apuder/MiniPC/src/esp/doc/programmer-20k.jpg

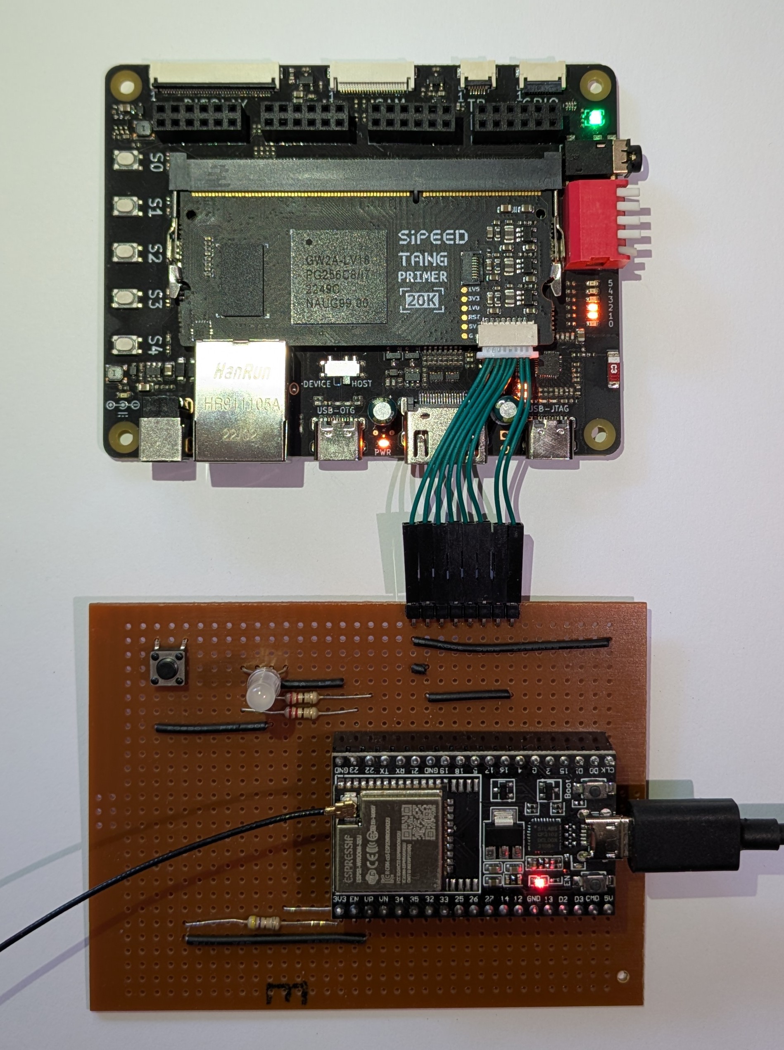
src/esp/doc/programmer-20k.jpg
