apuder/MiniPC/src/esp/doc/web-ui.png

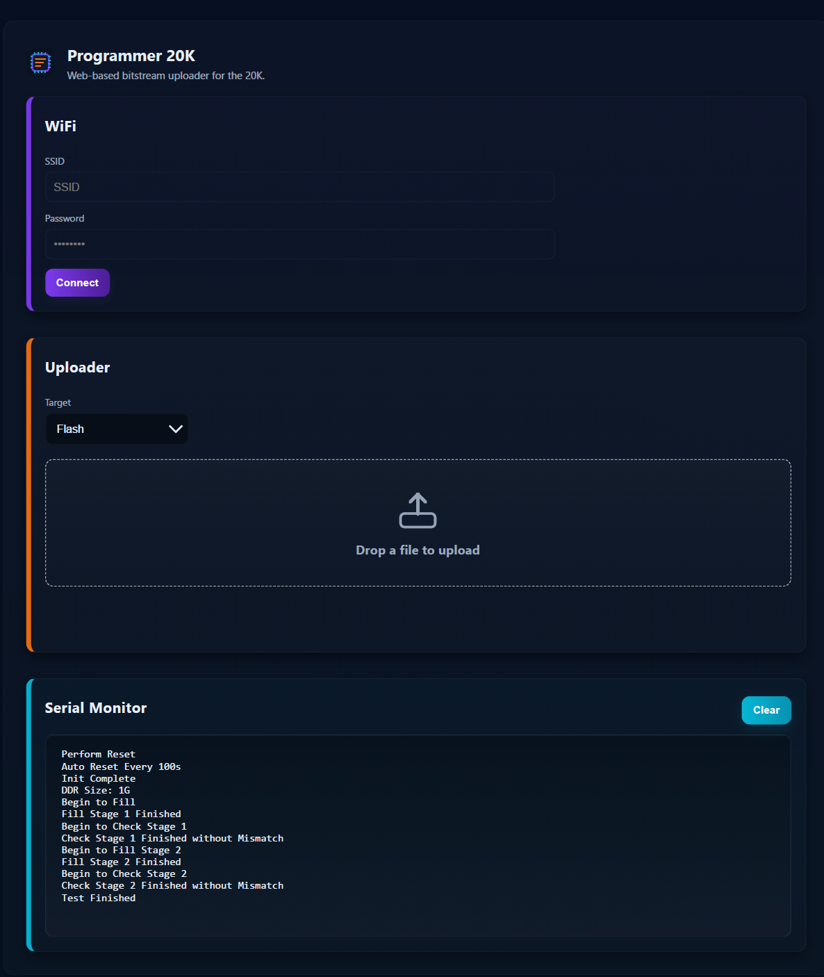
src/esp/doc/web-ui.png
