apuder/MiniPC/src/esp/doc/Programmer-20K-ESP.pdf

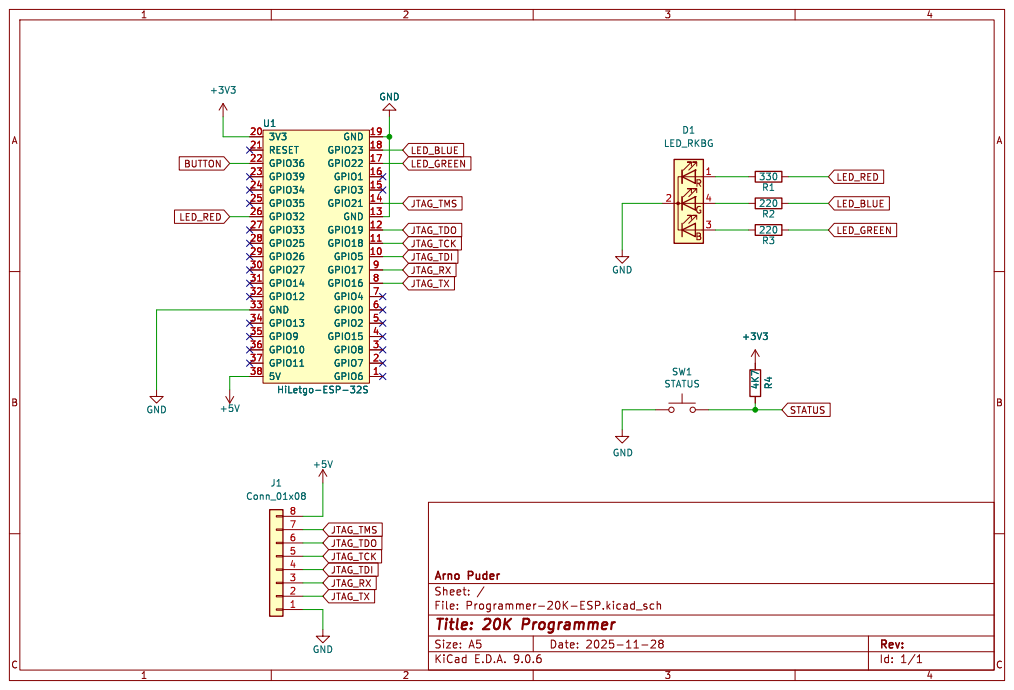
[picture p3: page 1]
