apuder/MiniPC/kicad/pc/v0.2/MiniPC.kicad_pcb

## KiCad design kicad/pc/v0.2/MiniPC.kicad_pcb (2026-04-09)

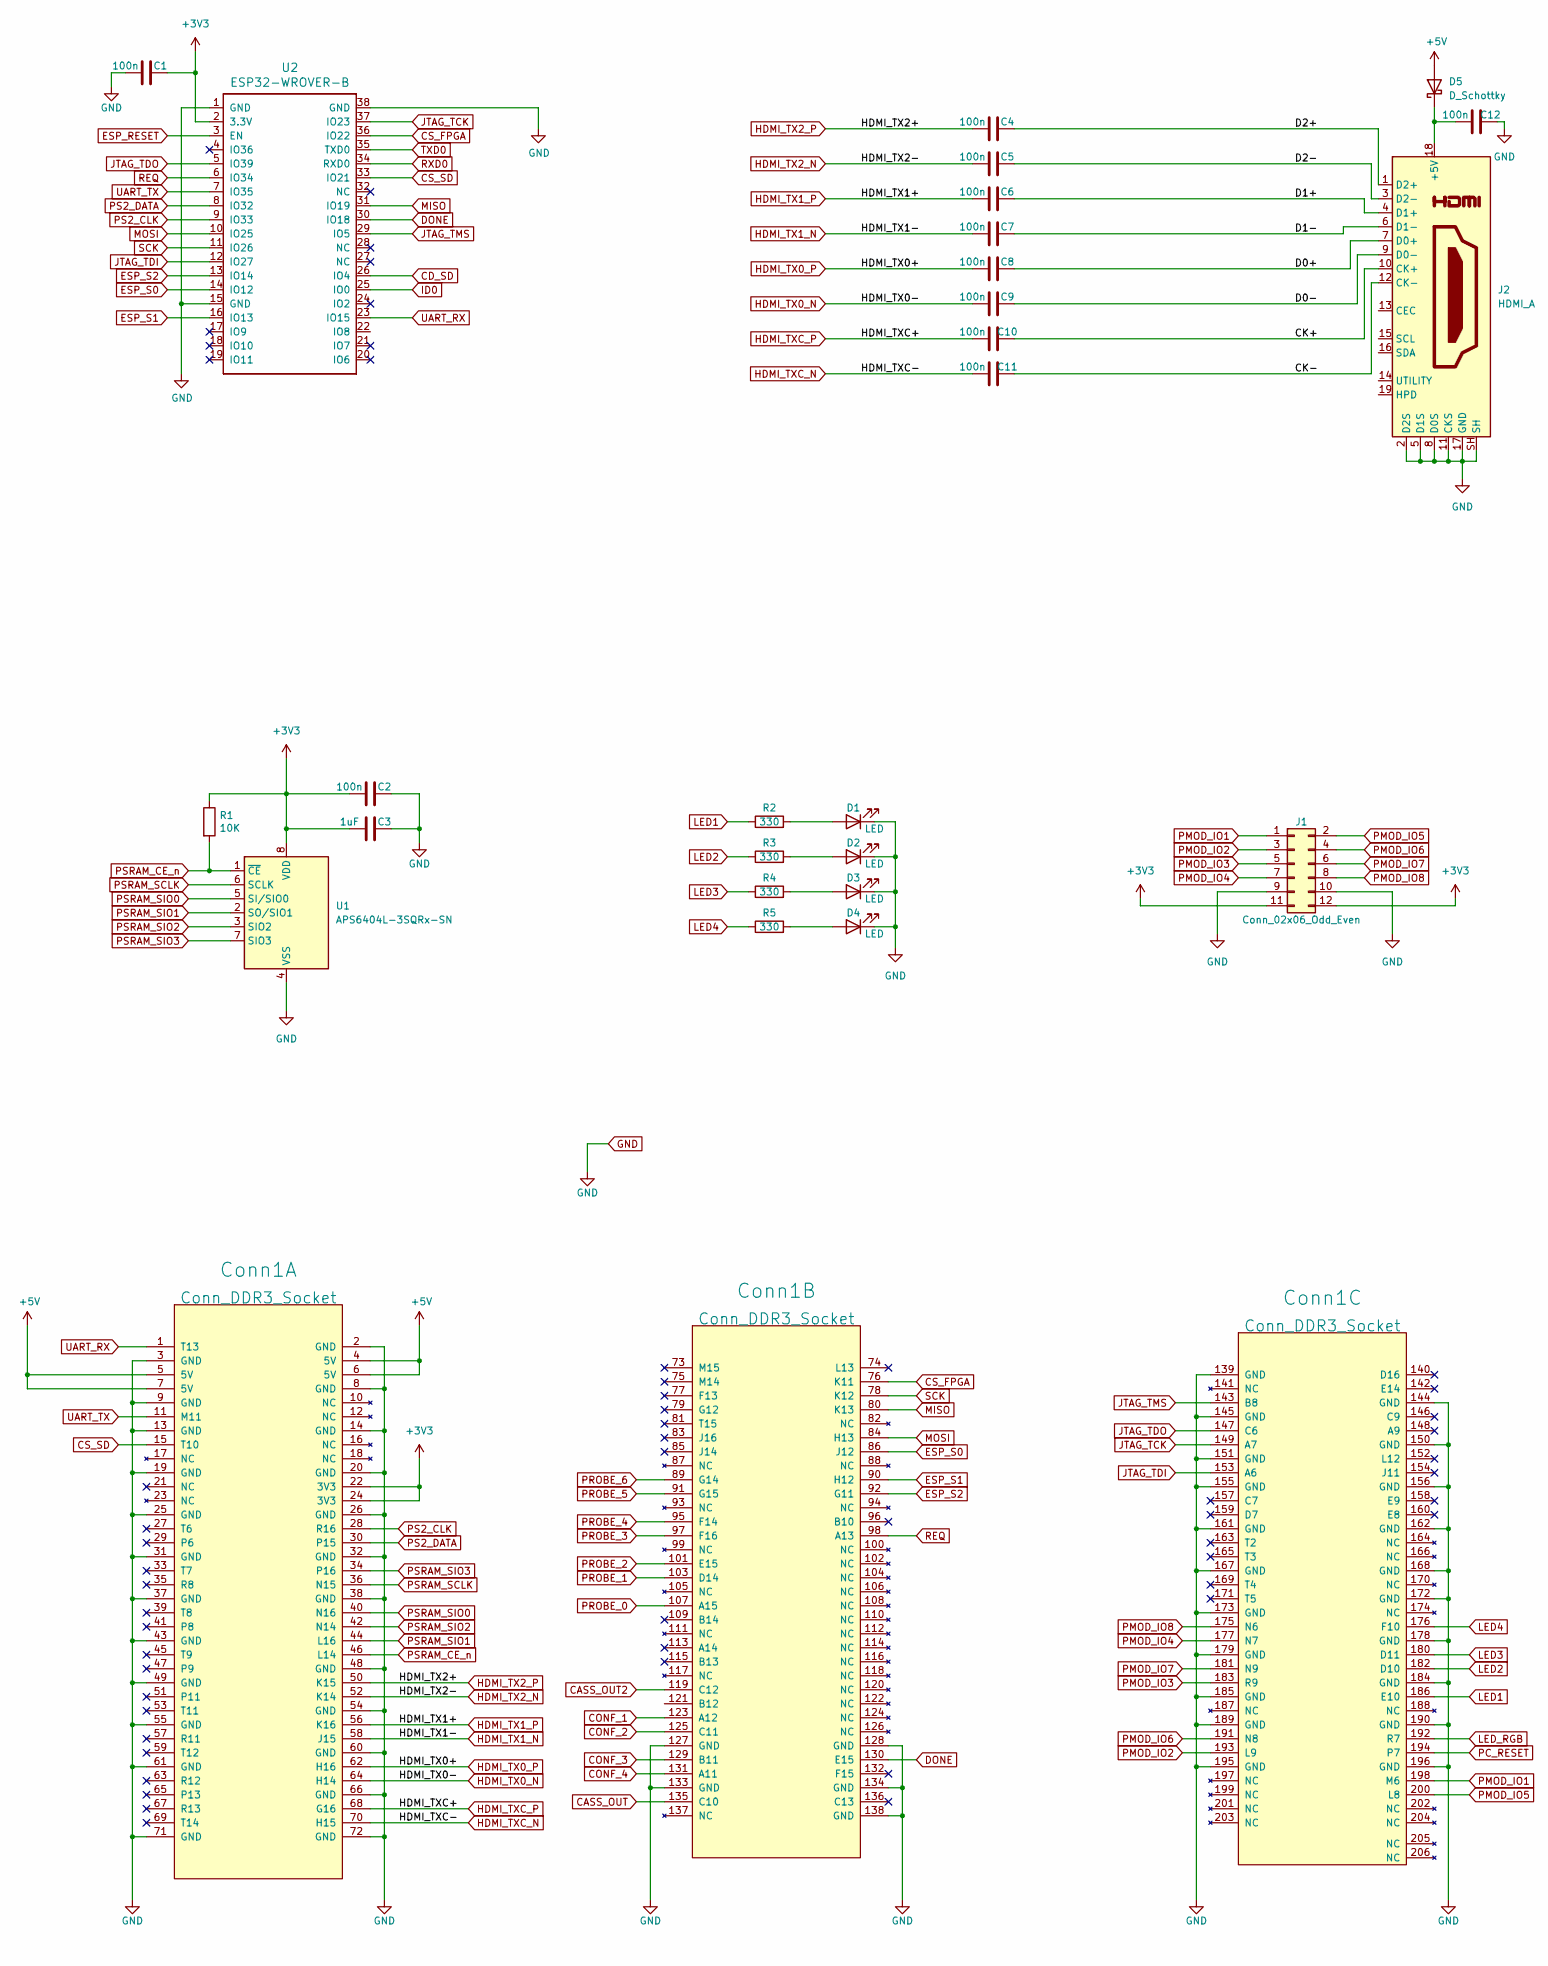
[picture p4: schematic MiniPC.kicad_sch, part in row 1, column 1]

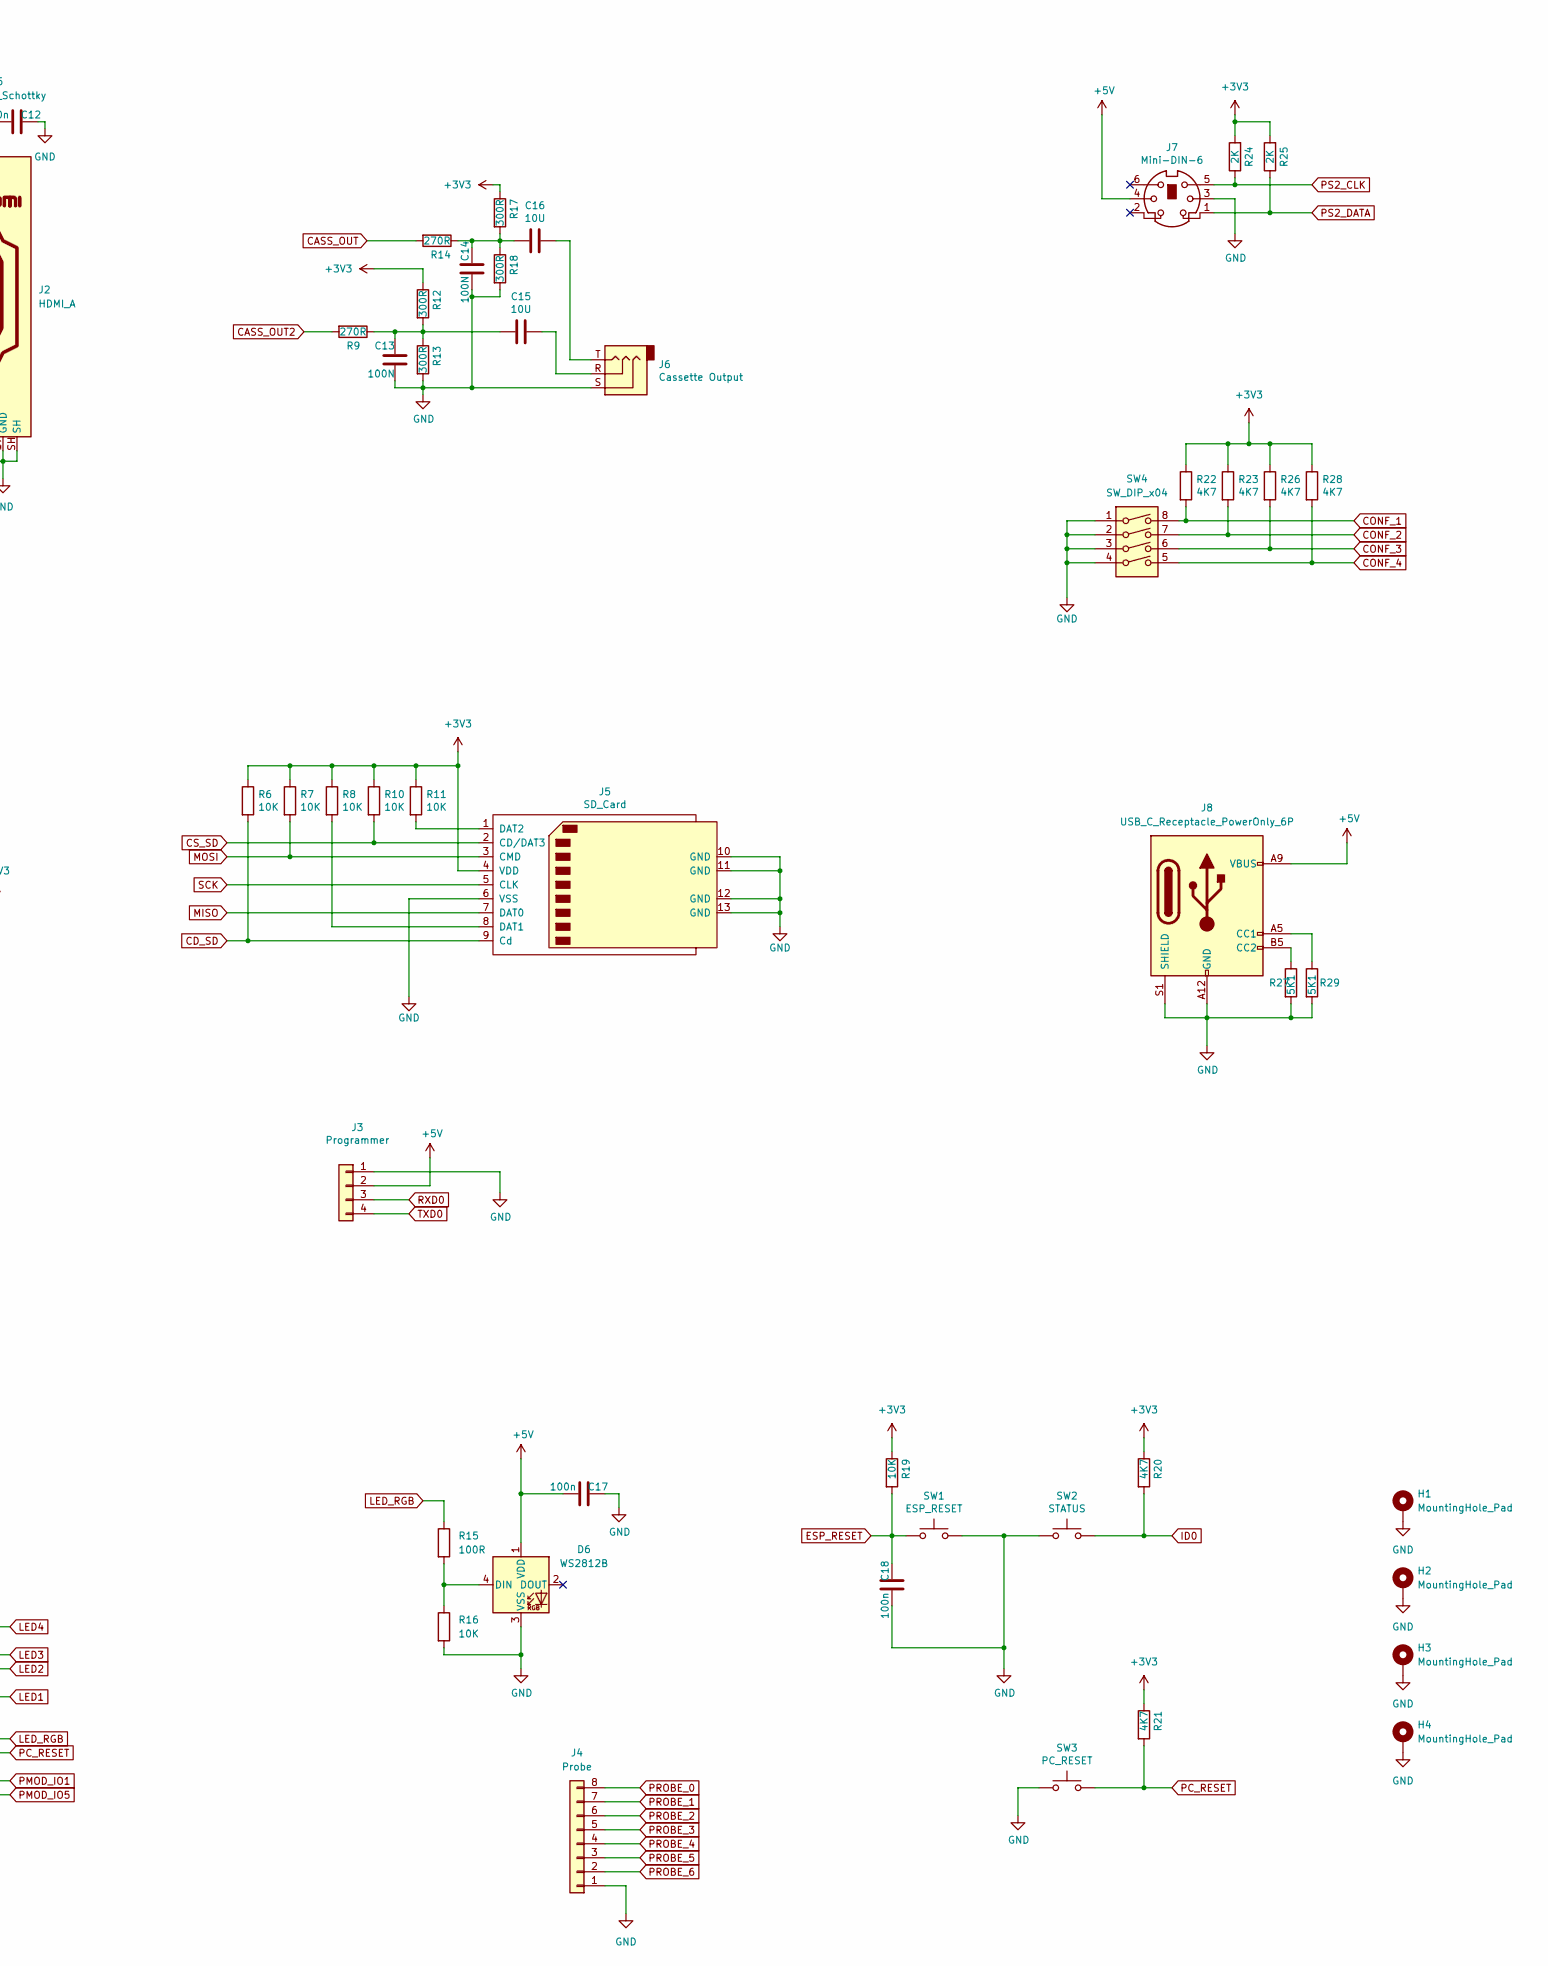
[picture p5: schematic MiniPC.kicad_sch, part in row 1, column 2]

Parts:
C1, C2, C4, C5, C6, C7, C8, C9, C10, C11, C12, C17, C18: 100n; C_0805_2012Metric_Pad1.18x1.45mm_HandSolder
C3: 1uF; C_0805_2012Metric_Pad1.18x1.45mm_HandSolder
C13, C14: 100N; C_0805_2012Metric_Pad1.18x1.45mm_HandSolder
C15, C16: 10U; C_1206_3216Metric_Pad1.33x1.80mm_HandSolder
Conn1: Conn_DDR3_Socket; DDR3_socket; LCSC C306045
D1: LED; LED_0805_2012Metric_Pad1.15x1.40mm_HandSolder; LCSC C84256
D2, D3, D4: LED; LED_0805_2012Metric_Pad1.15x1.40mm_HandSolder
D5: D_Schottky; D_SOD-323; LCSC C1884554
D6: WS2812B; LED_WS2812B_PLCC4_5.0x5.0mm_P3.2mm; LCSC C2761795
H1, H2, H3, H4: MountingHole_Pad; MountingHole_3mm_Pad_Via
J1: Conn_02x06_Odd_Even; PinSocket_2x06_P2.54mm_Vertical; LCSC C358728
J2: HDMI_A; HDMI_A_Molex_208658-1001_Horizontal; LCSC C5184845
J3: Programmer; PinHeader_1x04_P2.54mm_Vertical; LCSC C2691448
J4: Probe; PinHeader_1x08_P2.54mm_Vertical
J5: SD_Card; TFP09-2-12B; LCSC C91145
J6: Cassette Output; Jack_3.5mm_CUI_SJ1-3535NG_Horizontal_CircularHoles; LCSC C2884945
J7: Mini-DIN-6; minidin_6_ps2_pcb_mount; LCSC C77848
J8: USB_C_Receptacle_PowerOnly_6P; USB_C_Receptacle_GCT_USB4125-xx-x_6P_TopMnt_Horizontal; LCSC C168701
R1, R6, R7, R8, R10, R11, R16, R19: 10K; R_0805_2012Metric_Pad1.20x1.40mm_HandSolder
R2, R3, R4, R5: 330; R_0805_2012Metric_Pad1.20x1.40mm_HandSolder
R9, R14: 270R; R_0805_2012Metric_Pad1.20x1.40mm_HandSolder
R12, R13, R17, R18: 300R; R_0805_2012Metric_Pad1.20x1.40mm_HandSolder
R15: 100R; R_0805_2012Metric_Pad1.20x1.40mm_HandSolder
R20, R21, R22, R23, R26, R28: 4K7; R_0805_2012Metric_Pad1.20x1.40mm_HandSolder
R24, R25: 2K; R_0805_2012Metric_Pad1.20x1.40mm_HandSolder
R27, R29: 5K1; R_0805_2012Metric_Pad1.20x1.40mm_HandSolder
SW1: ESP_RESET; SW_Push_1P1T_NO_E-Switch_TL3301NxxxxxG; LCSC C255812
SW2: STATUS; SW_Push_1P1T_NO_E-Switch_TL3301NxxxxxG; LCSC C255812
SW3: PC_RESET; SW_Push_1P1T_NO_E-Switch_TL3301NxxxxxG; LCSC C255812
SW4: SW_DIP_x04; SW_DIP_SPSTx04_Slide_6.7x11.72mm_W8.61mm_P2.54mm_LowProfile; LCSC C2842911
U1: APS6404L-3SQRx-SN; SOIC-8_3.9x4.9mm_P1.27mm; LCSC C5333729
U2: ESP32-WROVER-B; ESP32-WROVER; LCSC C529589

Connections:
+3V3: C1.2, C2.1, C3.1, Conn1.22 (3V3), Conn1.24 (3V3), J1.11, J1.12, J5.4 (VDD), R1.1, R6.1, R7.1, R8.1, R10.1, R11.1, R12.1, R17.1, R19.1, R20.1, R21.1, R22.1, R23.1, R24.2, R25.2, R26.1, R28.1, U1.8 (VDD), U2.2 (3.3V)
+5V: C17.1, Conn1.4 (5V), Conn1.5 (5V), Conn1.6 (5V), Conn1.7 (5V), D5.2 (A), D6.1 (VDD), J3.2, J7.4, J8.A9 (VBUS), J8.B9 (VBUS)
/CK+: C10.2, J2.10 (CK+)
/CK-: C11.2, J2.12 (CK-)
/D0+: C8.2, J2.7 (D0+)
/D0-: C9.2, J2.9 (D0-)
/D1+: C6.2, J2.4 (D1+)
/D1-: C7.2, J2.6 (D1-)
/D2+: C4.2, J2.1 (D2+)
/D2-: C5.2, J2.3 (D2-)
CASS_OUT: Conn1.135 (C10), R14.2
CASS_OUT2: Conn1.119 (C12), R9.2
CD_SD: J5.9 (Cd), R6.2, U2.26 (IO4)
CONF_1: Conn1.123 (A12), R22.2, SW4.8
CONF_2: Conn1.125 (C11), R23.2, SW4.7
CONF_3: Conn1.129 (B11), R26.2, SW4.6
CONF_4: Conn1.131 (A11), R28.2, SW4.5
CS_FPGA: Conn1.76 (K11), U2.36 (IO22)
CS_SD: Conn1.15 (T10), J5.2 (CD/DAT3), R10.2, U2.33 (IO21)
DONE: Conn1.130 (E15), U2.30 (IO18)
ESP_RESET: C18.2, R19.2, SW1.1, U2.3 (EN)
ESP_S0: Conn1.86 (J12), U2.14 (IO12)
ESP_S1: Conn1.90 (H12), U2.16 (IO13)
ESP_S2: Conn1.92 (G11), U2.13 (IO14)
GND: C1.1, C2.2, C3.2, C12.2, C13.2, C14.2, C17.2, C18.1, Conn1.2 (GND), Conn1.3 (GND), Conn1.8 (GND), Conn1.9 (GND), Conn1.13 (GND), Conn1.14 (GND), Conn1.19 (GND), Conn1.20 (GND), Conn1.25 (GND), Conn1.26 (GND), Conn1.31 (GND), Conn1.32 (GND), Conn1.37 (GND), Conn1.38 (GND), Conn1.43 (GND), Conn1.48 (GND), Conn1.49 (GND), Conn1.54 (GND), Conn1.55 (GND), Conn1.60 (GND), Conn1.61 (GND), Conn1.66 (GND), Conn1.71 (GND), Conn1.72 (GND), Conn1.127 (GND), Conn1.128 (GND), Conn1.133 (GND), Conn1.134 (GND), Conn1.138 (GND), Conn1.139 (GND), Conn1.144 (GND), Conn1.145 (GND), Conn1.150 (GND), Conn1.151 (GND), Conn1.155 (GND), Conn1.156 (GND), Conn1.161 (GND), Conn1.162 (GND), Conn1.167 (GND), Conn1.168 (GND), Conn1.172 (GND), Conn1.173 (GND), Conn1.178 (GND), Conn1.179 (GND), Conn1.184 (GND), Conn1.185 (GND), Conn1.189 (GND), Conn1.190 (GND), Conn1.195 (GND), Conn1.196 (GND), D1.1 (K), D2.1 (K), D3.1 (K), D4.1 (K), D6.3 (VSS), H1.1, H2.1, H3.1, H4.1, J1.9, J1.10, J2.2 (D2S), J2.5 (D1S), J2.8 (D0S), J2.11 (CKS), J2.17 (GND), J2.SH, J3.1, J4.1, J5.6 (VSS), J5.10 (GND), J5.11 (GND), J5.12 (GND), J5.13 (GND), J6.S, J7.3, J8.A12 (GND), J8.B12 (GND), J8.S1 (SHIELD), R13.2, R16.2, R18.2, R27.2, R29.2, SW1.2, SW2.1, SW3.1, SW4.1, SW4.2, SW4.3, SW4.4, U1.4 (VSS), U2.1 (GND), U2.15 (GND), U2.38 (GND)
HDMI_TX0_N: C9.1, Conn1.64 (H14)
HDMI_TX0_P: C8.1, Conn1.62 (H16)
HDMI_TX1_N: C7.1, Conn1.58 (J15)
HDMI_TX1_P: C6.1, Conn1.56 (K16)
HDMI_TX2_N: C5.1, Conn1.52 (K14)
HDMI_TX2_P: C4.1, Conn1.50 (K15)
HDMI_TXC_N: C11.1, Conn1.70 (H15)
HDMI_TXC_P: C10.1, Conn1.68 (G16)
ID0: R20.2, SW2.2, U2.25 (IO0)
JTAG_TCK: Conn1.149 (A7), U2.37 (IO23)
JTAG_TDI: Conn1.153 (A6), U2.12 (IO27)
JTAG_TDO: Conn1.147 (C6), U2.5 (IO39)
JTAG_TMS: Conn1.143 (B8), U2.29 (IO5)
LED1: Conn1.186 (E10), R2.1
LED2: Conn1.182 (D10), R3.1
LED3: Conn1.180 (D11), R4.1
LED4: Conn1.176 (F10), R5.1
LED_RGB: Conn1.192 (R7), R15.1
MISO: Conn1.80 (K13), J5.7 (DAT0), U2.31 (IO19)
MOSI: Conn1.84 (H13), J5.3 (CMD), R7.2, U2.10 (IO25)
unnamed: C13.1, C15.2, R9.1, R12.2, R13.1
unnamed: C14.1, C16.2, R14.1, R17.2, R18.1
unnamed: C15.1, J6.R
unnamed: C16.1, J6.T
unnamed: D1.2 (A), R2.2
unnamed: D2.2 (A), R3.2
unnamed: D3.2 (A), R4.2
unnamed: D4.2 (A), R5.2
unnamed: C12.1, D5.1 (K), J2.18 (+5V)
unnamed: D6.4 (DIN), R15.2, R16.1
unnamed: J5.8 (DAT1), R8.2
unnamed: J5.1 (DAT2), R11.2
unnamed: J8.A5 (CC1), R29.1
unnamed: J8.B5 (CC2), R27.1
PC_RESET: Conn1.194 (P7), R21.2, SW3.2
PMOD_IO1: Conn1.198 (M6), J1.1
PMOD_IO2: Conn1.193 (L9), J1.3
PMOD_IO3: Conn1.183 (R9), J1.5
PMOD_IO4: Conn1.177 (N7), J1.7
PMOD_IO5: Conn1.200 (L8), J1.2
PMOD_IO6: Conn1.191 (N8), J1.4
PMOD_IO7: Conn1.181 (N9), J1.6
PMOD_IO8: Conn1.175 (N6), J1.8
PROBE_0: Conn1.107 (A15), J4.8
PROBE_1: Conn1.103 (D14), J4.7
PROBE_2: Conn1.101 (E15), J4.6
PROBE_3: Conn1.97 (F16), J4.5
PROBE_4: Conn1.95 (F14), J4.4
PROBE_5: Conn1.91 (G15), J4.3
PROBE_6: Conn1.89 (G14), J4.2
PS2_CLK: Conn1.28 (R16), J7.5, R24.1, U2.9 (IO33)
PS2_DATA: Conn1.30 (P15), J7.1, R25.1, U2.8 (IO32)
PSRAM_CE_n: Conn1.46 (L14), R1.2, U1.1 (~CE)
PSRAM_SCLK: Conn1.36 (N15), U1.6 (SCLK)
PSRAM_SIO0: Conn1.40 (N16), U1.5 (SI/SIO0)
PSRAM_SIO1: Conn1.44 (L16), U1.2 (SO/SIO1)
PSRAM_SIO2: Conn1.42 (N14), U1.3 (SIO2)
PSRAM_SIO3: Conn1.34 (P16), U1.7 (SIO3)
REQ: Conn1.98 (A13), U2.6 (IO34)
RXD0: J3.3, U2.34 (RXD0)
SCK: Conn1.78 (K12), J5.5 (CLK), U2.11 (IO26)
TXD0: J3.4, U2.35 (TXD0)
UART_RX: Conn1.1 (T13), U2.23 (IO15)
UART_TX: Conn1.11 (M11), U2.7 (IO35)

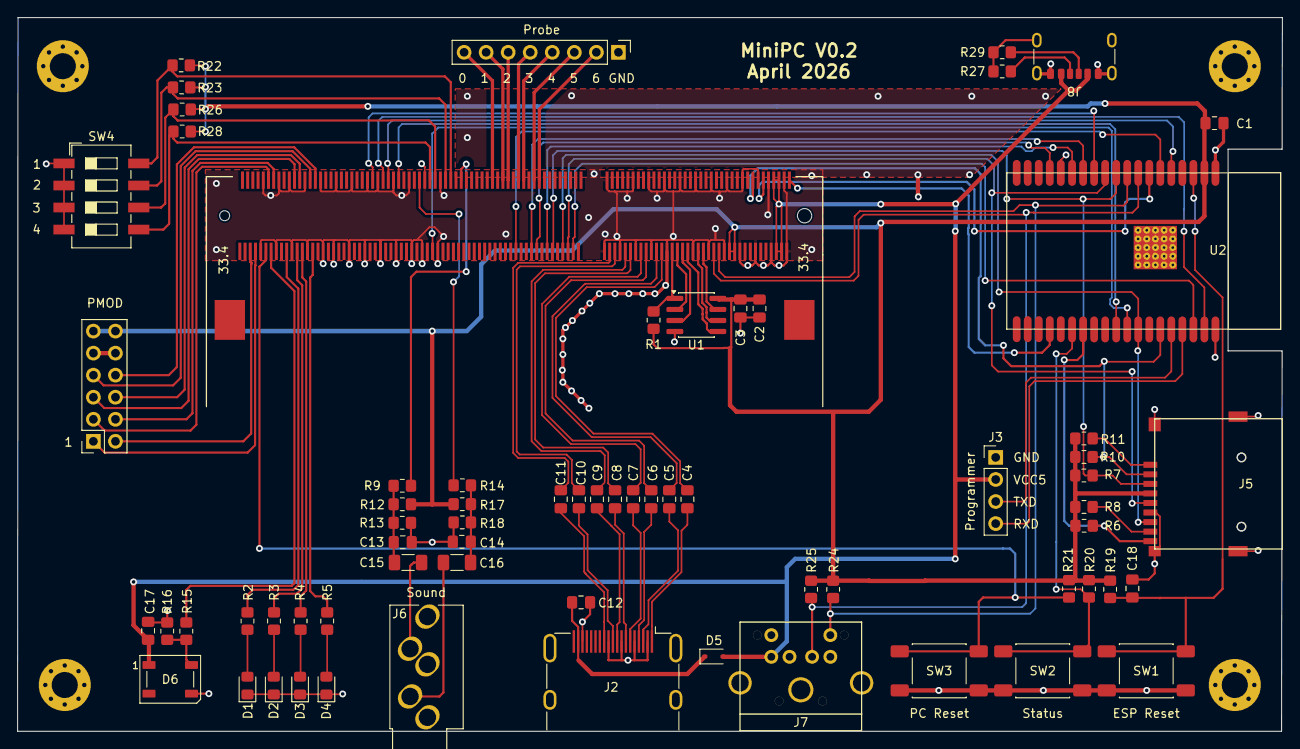
[picture p6: board MiniPC.kicad_pcb from above]

Board: 2 copper layers, 145.7 x 82.2 mm, 72 parts (0 on the bottom side), 89 nets.
