apuder/MiniPC/kicad/pmod/rs232/rs232.kicad_pcb

## KiCad design kicad/pmod/rs232/rs232.kicad_pcb (2026-03-08)

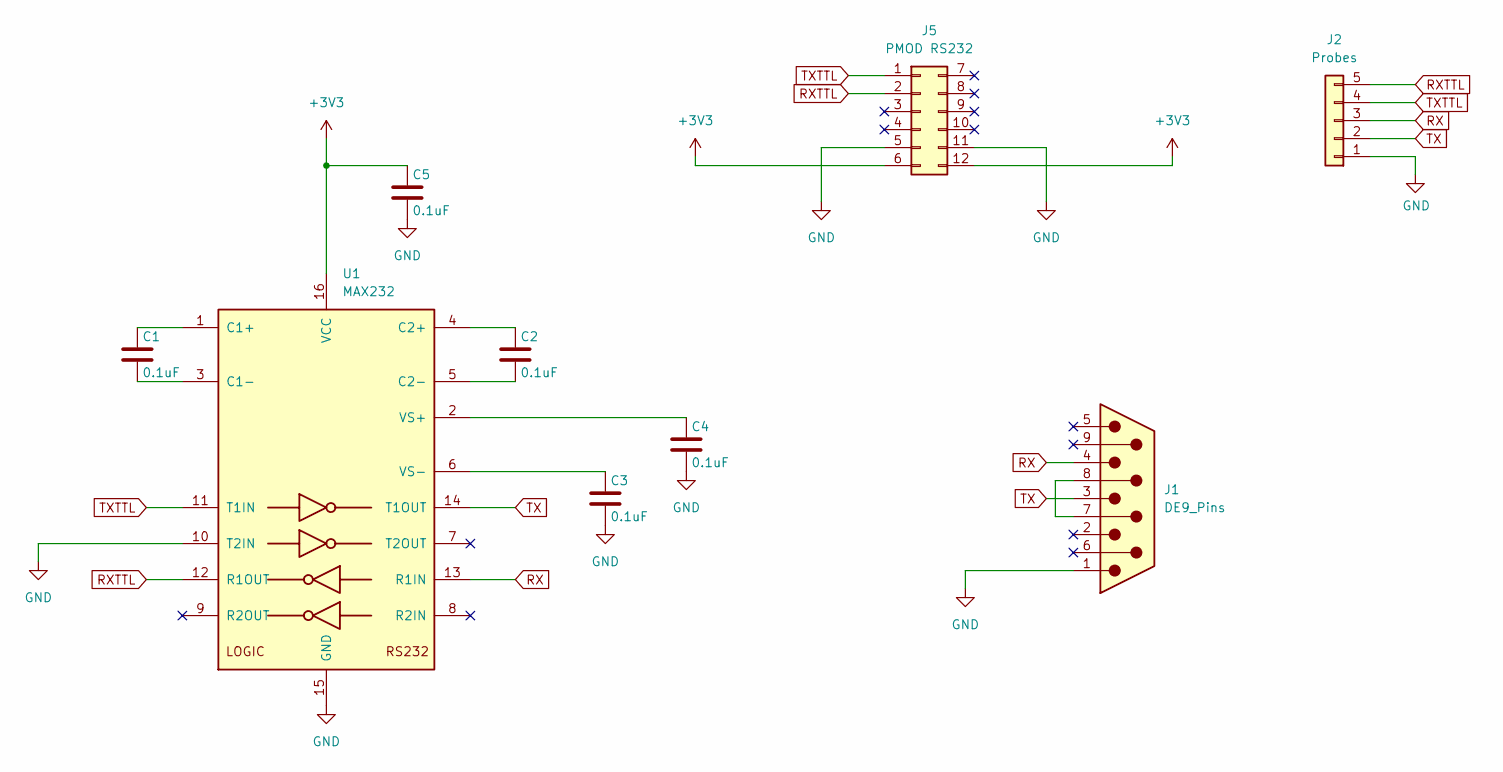
[picture p7: schematic rs232.kicad_sch, PMOD - RS232]

Parts:
C1, C2, C3, C4, C5: 0.1uF; C_0805_2012Metric_Pad1.18x1.45mm_HandSolder; LCSC C49678
J1: DE9_Pins; DSUB-9_Socket_Horizontal_P2.77x2.84mm_EdgePinOffset7.70mm_H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
J2: Probes; PinHeader_1x05_P2.54mm_Vertical
J5: PMOD RS232; PinSocket_2x06_Top_Bottom_P2.54mm_Vertical; LCSC C358728
U1: MAX232; TSSOP-16_4.4x5mm_P0.65mm; LCSC C406863

Connections:
+3V3: C5.1, J5.6, J5.12, U1.16 (VCC)
GND: C3.2, C4.2, C5.2, J1.1, J2.1, J5.5, J5.11, U1.10 (T2IN), U1.15 (GND)
unnamed: J1.7, J1.8
unnamed: C1.1, U1.1 (C1+)
unnamed: C1.2, U1.3 (C1-)
unnamed: C2.1, U1.4 (C2+)
unnamed: C2.2, U1.5 (C2-)
unnamed: C4.1, U1.2 (VS+)
unnamed: C3.1, U1.6 (VS-)
RX: J1.4, J2.3, U1.13 (R1IN)
RXTTL: J2.5, J5.2, U1.12 (R1OUT)
TX: J1.3, J2.2, U1.14 (T1OUT)
TXTTL: J2.4, J5.1, U1.11 (T1IN)

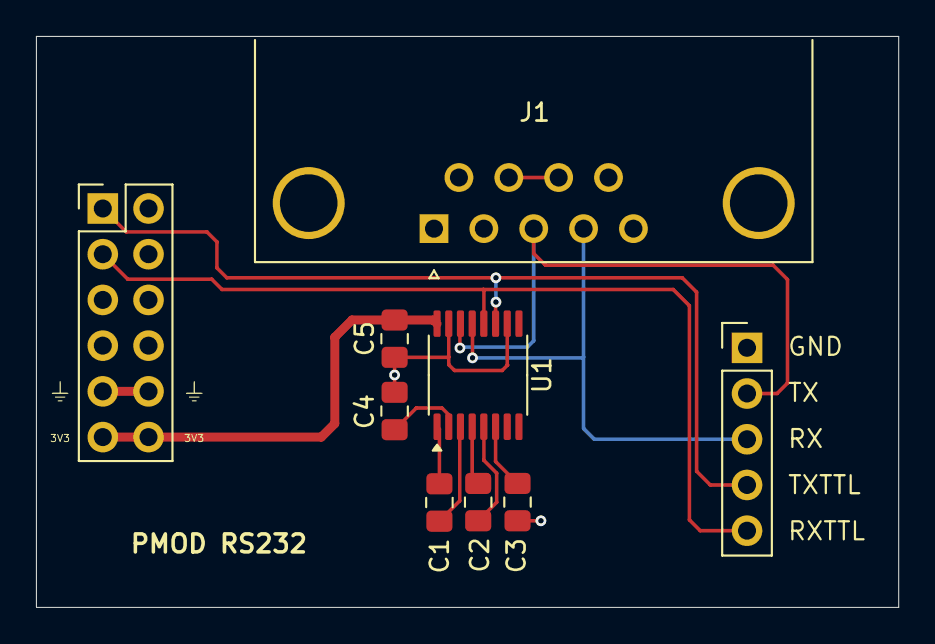
[picture p8: board rs232.kicad_pcb from above]

Board: 2 copper layers, 47.9 x 31.7 mm, 9 parts (0 on the bottom side), 13 nets.
