apuder/MiniPC/src/tos/kernel/window.c

#include <kernel.h>


/* TOS_IFDEF assn2 */
#define SCREEN_BASE_ADDR 0x50000000
#define SCREEN_WIDTH     80
#define SCREEN_HEIGHT    24


WORD            default_color = 0x0f;



void poke_screen(int x, int y, WORD ch)
{
    poke_b(SCREEN_BASE_ADDR + y * SCREEN_WIDTH + x , ch & 0xff);
}



WORD peek_screen(int x, int y)
{
    return peek_b(SCREEN_BASE_ADDR + y * SCREEN_WIDTH + x);
}



void scroll_window(WINDOW * wnd)
{
    int             x,
                    y;
    int             wx,
                    wy;
    /* TOS_IFDEF assn7 */
    volatile int    flag;
    /* TOS_ENDIF assn7 */

    /* TOS_IFDEF assn7 */
    DISABLE_INTR(flag);
    /* TOS_ENDIF assn7 */
    for (y = 0; y < wnd->height - 1; y++) {
        wy = wnd->y + y;
        for (x = 0; x < wnd->width; x++) {
            wx = wnd->x + x;
            WORD            ch = peek_screen(wx, wy + 1);
            poke_screen(wx, wy, ch);
        }
    }
    wy = wnd->y + wnd->height - 1;
    for (x = 0; x < wnd->width; x++) {
        wx = wnd->x + x;
        poke_screen(wx, wy, 0);
    }
    wnd->cursor_x = 0;
    wnd->cursor_y = wnd->height - 1;
    /* TOS_IFDEF assn7 */
    ENABLE_INTR(flag);
    /* TOS_ENDIF assn7 */
}
/* TOS_ENDIF assn2 */


void move_cursor(WINDOW * wnd, int x, int y)
{
    /* TOS_IFDEF assn2 */
    assert(x < wnd->width && y < wnd->height);
    wnd->cursor_x = x;
    wnd->cursor_y = y;
    /* TOS_ENDIF assn2 */
}


void remove_cursor(WINDOW * wnd)
{
    /* TOS_IFDEF assn2 */
    poke_screen(wnd->x + wnd->cursor_x, wnd->y + wnd->cursor_y, ' ');
    /* TOS_ENDIF assn2 */
}


void show_cursor(WINDOW * wnd)
{
    /* TOS_IFDEF assn2 */
    poke_screen(wnd->x + wnd->cursor_x,
                wnd->y + wnd->cursor_y,
                wnd->cursor_char | (default_color << 8));
    /* TOS_ENDIF assn2 */
}


void clear_window(WINDOW * wnd)
{
    /* TOS_IFDEF assn2 */
    int             x,
                    y;
    int             wx,
                    wy;

    /* TOS_IFDEF assn7 */
    volatile int    flag;

    DISABLE_INTR(flag);
    /* TOS_ENDIF assn7 */
    wnd->cursor_x = 0;
    wnd->cursor_y = 0;
    for (y = 0; y < wnd->height; y++) {
        wy = wnd->y + y;
        for (x = 0; x < wnd->width; x++) {
            wx = wnd->x + x;
            poke_screen(wx, wy, 0);
        }
    }
    show_cursor(wnd);
    /* TOS_IFDEF assn7 */
    ENABLE_INTR(flag);
    /* TOS_ENDIF assn7 */
    /* TOS_ENDIF assn2 */
}


void output_char(WINDOW * wnd, unsigned char c)
{
    /* TOS_IFDEF assn2 */
    /* TOS_IFDEF assn7 */
    volatile int    flag;

    DISABLE_INTR(flag);
    /* TOS_ENDIF assn7 */
    remove_cursor(wnd);
    switch (c) {
    case '\n':
    case 13:
        wnd->cursor_x = 0;
        wnd->cursor_y++;
        break;
    case '\b':
        if (wnd->cursor_x != 0) {
            wnd->cursor_x--;
        } else {
            if (wnd->cursor_y != 0) {
                wnd->cursor_x = wnd->width - 1;
                wnd->cursor_y--;
            }
        }
        break;
    default:
        poke_screen(wnd->x + wnd->cursor_x,
                    wnd->y + wnd->cursor_y,
                    (short unsigned int) c | (default_color << 8));
        wnd->cursor_x++;
        if (wnd->cursor_x == wnd->width) {
            wnd->cursor_x = 0;
            wnd->cursor_y++;
        }
        break;
    }
    if (wnd->cursor_y == wnd->height)
        scroll_window(wnd);
    show_cursor(wnd);
    /* TOS_IFDEF assn7 */
    ENABLE_INTR(flag);
    /* TOS_ENDIF assn7 */
    /* TOS_ENDIF assn2 */
}



void output_string(WINDOW * wnd, const char *str)
{
    /* TOS_IFDEF assn2 */
    while (*str != '\0')
        output_char(wnd, *str++);
    /* TOS_ENDIF assn2 */
}



/* 
 * There is not need to make any changes to the code below,
 * however, you are encouraged to at least look at it!
 */
#define MAXBUF (sizeof(long int) * 8)   /* enough for binary */

char           *printnum(char *b, unsigned int u, int base,
                         BOOL negflag, int length, BOOL ladjust,
                         char padc, BOOL upcase)
{
    char            buf[MAXBUF];        /* build number here */
    char           *p = &buf[MAXBUF - 1];
    int             size;
    char           *digs;
    static char     up_digs[] = "0123456789ABCDEF";
    static char     low_digs[] = "0123456789abcdef";

    digs = upcase ? up_digs : low_digs;
    do {
        *p-- = digs[u % base];
        u /= base;
    } while (u != 0);

    if (negflag)
        *b++ = '-';

    size = &buf[MAXBUF - 1] - p;

    if (size < length && !ladjust) {
        while (length > size) {
            *b++ = padc;
            length--;
        }
    }

    while (++p != &buf[MAXBUF])
        *b++ = *p;

    if (size < length) {
        /* must be ladjust */
        while (length > size) {
            *b++ = padc;
            length--;
        }
    }
    return b;
}


/* 
 *  This version implements therefore following printf features:
 *
 *      %d      decimal conversion
 *      %u      unsigned conversion
 *      %x      hexadecimal conversion
 *      %X      hexadecimal conversion with capital letters
 *      %o      octal conversion
 *      %c      character
 *      %s      string
 *      %m.n    field width, precision
 *      %-m.n   left adjustment
 *      %0m.n   zero-padding
 *      %*.*    width and precision taken from arguments
 *
 *  This version does not implement %f, %e, or %g.  It accepts, but
 *  ignores, an `l' as in %ld, %lo, %lx, and %lu, and therefore will not
 *  work correctly on machines for which sizeof(long) != sizeof(int).
 *  It does not even parse %D, %O, or %U; you should be using %ld, %o and
 *  %lu if you mean long conversion.
 *
 *  This version implements the following nonstandard features:
 *
 *      %b      binary conversion
 *
 */


#define isdigit(d) ((d) >= '0' && (d) <= '9')
#define ctod(c) ((c) - '0')


int k_vsprintf(char *buf, const char *fmt, va_list argp)
{
    char           *p;
    char           *p2;
    int             length;
    int             prec;
    int             ladjust;
    char            padc;
    int             n;
    unsigned int    u;
    int             negflag;
    char            c;
    char           *start_buf = buf;

    while (*fmt != '\0') {
        if (*fmt != '%') {
            *buf++ = *fmt++;
            continue;
        }
        fmt++;
        if (*fmt == 'l')
            fmt++;              /* need to use it if sizeof(int) <
                                 * sizeof(long) */

        length = 0;
        prec = -1;
        ladjust = FALSE;
        padc = ' ';

        if (*fmt == '-') {
            ladjust = TRUE;
            fmt++;
        }

        if (*fmt == '0') {
            padc = '0';
            fmt++;
        }

        if (isdigit(*fmt)) {
            while (isdigit(*fmt))
                length = 10 * length + ctod(*fmt++);
        } else if (*fmt == '*') {
            length = va_arg(argp, int);
            fmt++;
            if (length < 0) {
                ladjust = !ladjust;
                length = -length;
            }
        }

        if (*fmt == '.') {
            fmt++;
            if (isdigit(*fmt)) {
                prec = 0;
                while (isdigit(*fmt))
                    prec = 10 * prec + ctod(*fmt++);
            } else if (*fmt == '*') {
                prec = va_arg(argp, int);
                fmt++;
            }
        }

        negflag = FALSE;

        switch (*fmt) {
        case 'b':
        case 'B':
            u = va_arg(argp, unsigned int);
            buf = printnum(buf, u, 2, FALSE, length, ladjust, padc, 0);
            break;

        case 'c':
            c = va_arg(argp, int);
            *buf++ = c;
            break;

        case 'd':
        case 'D':
            n = va_arg(argp, int);
            if (n >= 0)
                u = n;
            else {
                u = -n;
                negflag = TRUE;
            }
            buf = printnum(buf, u, 10, negflag, length, ladjust, padc, 0);
            break;

        case 'o':
        case 'O':
            u = va_arg(argp, unsigned int);
            buf = printnum(buf, u, 8, FALSE, length, ladjust, padc, 0);
            break;

        case 's':
            p = va_arg(argp, char *);
            if (p == (char *) 0)
                p = "(NULL)";
            if (length > 0 && !ladjust) {
                n = 0;
                p2 = p;
                for (; *p != '\0' && (prec == -1 || n < prec); p++)
                    n++;
                p = p2;
                while (n < length) {
                    *buf++ = ' ';
                    n++;
                }
            }
            n = 0;
            while (*p != '\0') {
                if (++n > prec && prec != -1)
                    break;
                *buf++ = *p++;
            }
            if (n < length && ladjust) {
                while (n < length) {
                    *buf++ = ' ';
                    n++;
                }
            }
            break;

        case 'u':
        case 'U':
            u = va_arg(argp, unsigned int);
            buf = printnum(buf, u, 10, FALSE, length, ladjust, padc, 0);
            break;

        case 'x':
            u = va_arg(argp, unsigned int);
            buf = printnum(buf, u, 16, FALSE, length, ladjust, padc, 0);
            break;

        case 'X':
            u = va_arg(argp, unsigned int);
            buf = printnum(buf, u, 16, FALSE, length, ladjust, padc, 1);
            break;

        case '\0':
            fmt--;
            break;

        default:
            *buf++ = *fmt;
        }
        fmt++;
    }
    *buf = '\0';
    return buf - start_buf;
}



int k_sprintf(char *buf, const char *fmt, ...)
{
    va_list         argp;
    int             ret;

    va_start(argp, fmt);
    ret = k_vsprintf(buf, fmt, argp);
    va_end(argp);
    return ret;
}


void wprintf(WINDOW * wnd, const char *fmt, ...)
{
    va_list         argp;
    char            buf[160];

    va_start(argp, fmt);
    vsprintf(buf, fmt, argp);
    output_string(wnd, buf);
    va_end(argp);
}




static WINDOW   kernel_window_def = { 0, 0, 80, 24, 0, 0, ' ' };
WINDOW         *kernel_window = &kernel_window_def;


void kprintf(const char *fmt, ...)
{
    va_list         argp;
    char            buf[160];

    va_start(argp, fmt);
    vsprintf(buf, fmt, argp);
    output_string(kernel_window, buf);
    va_end(argp);
}


/* TOS_IFDEF never */

/* 
 * The following code is a reference implementation of the first
 * assignment for CSC720.
 */

#define FRAME_TOP_LEFT     0xDA
#define FRAME_TOP_RIGHT    0xBF
#define FRAME_BOTTOM_LEFT  0xC0
#define FRAME_BOTTOM_RIGHT 0xD9
#define FRAME_VERTICAL     0xB3
#define FRAME_HORIZONTAL   0xC4



void poke_screen_clip(int x, int y, WORD ch)
{
    if (x < 0 || x >= SCREEN_WIDTH)
        return;
    if (y < 0 || y >= SCREEN_HEIGHT)
        return;
    poke_screen(x, y, ch | (default_color << 8));
}



void draw_frame(WINDOW * wnd)
{
    int             x1 = wnd->x - 1;
    int             y1 = wnd->y - 1;
    int             x2 = wnd->x + wnd->width;
    int             y2 = wnd->y + wnd->height;

    poke_screen_clip(x1, y1, FRAME_TOP_LEFT);
    poke_screen_clip(x1, y2, FRAME_BOTTOM_LEFT);
    poke_screen_clip(x2, y1, FRAME_TOP_RIGHT);
    poke_screen_clip(x2, y2, FRAME_BOTTOM_RIGHT);

    int             i;
    for (i = x1 + 1; i < x2; i++) {
        poke_screen_clip(i, y1, FRAME_HORIZONTAL);
        poke_screen_clip(i, y2, FRAME_HORIZONTAL);
    }

    for (i = y1 + 1; i < y2; i++) {
        poke_screen_clip(x1, i, FRAME_VERTICAL);
        poke_screen_clip(x2, i, FRAME_VERTICAL);
    }
}
/* TOS_ENDIF never */
