apuder/MiniPC/src/fpga/mini-pc/v0.1/src/gowin_dpb/blk_mem_gen_0.v

//Copyright (C)2014-2022 Gowin Semiconductor Corporation.
//All rights reserved.
//File Title: IP file
//GOWIN Version: V1.9.8.09 Education
//Part Number: GW2A-LV18PG256C8/I7
//Device: GW2A-18C
//Created Time: Sat Jun 17 05:38:22 2023

module blk_mem_gen_0 (douta, doutb, clka, ocea, cea, reseta, wrea, clkb, oceb, ceb, resetb, wreb, ada, dina, adb, dinb);

output [7:0] douta;
output [7:0] doutb;
input clka;
input ocea;
input cea;
input reseta;
input wrea;
input clkb;
input oceb;
input ceb;
input resetb;
input wreb;
input [13:0] ada;
input [7:0] dina;
input [13:0] adb;
input [7:0] dinb;

wire [13:0] dpb_inst_0_douta_w;
wire [1:0] dpb_inst_0_douta;
wire [13:0] dpb_inst_0_doutb_w;
wire [1:0] dpb_inst_0_doutb;
wire [13:0] dpb_inst_1_douta_w;
wire [3:2] dpb_inst_1_douta;
wire [13:0] dpb_inst_1_doutb_w;
wire [3:2] dpb_inst_1_doutb;
wire [13:0] dpb_inst_2_douta_w;
wire [5:4] dpb_inst_2_douta;
wire [13:0] dpb_inst_2_doutb_w;
wire [5:4] dpb_inst_2_doutb;
wire [13:0] dpb_inst_3_douta_w;
wire [7:6] dpb_inst_3_douta;
wire [13:0] dpb_inst_3_doutb_w;
wire [7:6] dpb_inst_3_doutb;
wire [11:0] dpb_inst_4_douta_w;
wire [3:0] dpb_inst_4_douta;
wire [11:0] dpb_inst_4_doutb_w;
wire [3:0] dpb_inst_4_doutb;
wire [11:0] dpb_inst_5_douta_w;
wire [7:4] dpb_inst_5_douta;
wire [11:0] dpb_inst_5_doutb_w;
wire [7:4] dpb_inst_5_doutb;
wire [7:0] dpb_inst_6_douta_w;
wire [7:0] dpb_inst_6_douta;
wire [7:0] dpb_inst_6_doutb_w;
wire [7:0] dpb_inst_6_doutb;
wire dff_q_0;
wire dff_q_1;
wire dff_q_2;
wire dff_q_3;
wire mux_o_4;
wire mux_o_10;
wire mux_o_16;
wire mux_o_22;
wire mux_o_28;
wire mux_o_34;
wire mux_o_40;
wire mux_o_46;
wire mux_o_52;
wire mux_o_58;
wire mux_o_64;
wire mux_o_70;
wire mux_o_76;
wire mux_o_82;
wire mux_o_88;
wire mux_o_94;
wire cea_w;
wire ceb_w;
wire gw_gnd;

assign cea_w = ~wrea & cea;
assign ceb_w = ~wreb & ceb;
assign gw_gnd = 1'b0;

DPB dpb_inst_0 (
    .DOA({dpb_inst_0_douta_w[13:0],dpb_inst_0_douta[1:0]}),
    .DOB({dpb_inst_0_doutb_w[13:0],dpb_inst_0_doutb[1:0]}),
    .CLKA(clka),
    .OCEA(ocea),
    .CEA(cea),
    .RESETA(reseta),
    .WREA(wrea),
    .CLKB(clkb),
    .OCEB(oceb),
    .CEB(ceb),
    .RESETB(resetb),
    .WREB(wreb),
    .BLKSELA({gw_gnd,gw_gnd,ada[13]}),
    .BLKSELB({gw_gnd,gw_gnd,adb[13]}),
    .ADA({ada[12:0],gw_gnd}),
    .DIA({gw_gnd,gw_gnd,gw_gnd,gw_gnd,gw_gnd,gw_gnd,gw_gnd,gw_gnd,gw_gnd,gw_gnd,gw_gnd,gw_gnd,gw_gnd,gw_gnd,dina[1:0]}),
    .ADB({adb[12:0],gw_gnd}),
    .DIB({gw_gnd,gw_gnd,gw_gnd,gw_gnd,gw_gnd,gw_gnd,gw_gnd,gw_gnd,gw_gnd,gw_gnd,gw_gnd,gw_gnd,gw_gnd,gw_gnd,dinb[1:0]})
);

defparam dpb_inst_0.READ_MODE0 = 1'b0;
defparam dpb_inst_0.READ_MODE1 = 1'b0;
defparam dpb_inst_0.WRITE_MODE0 = 2'b00;
defparam dpb_inst_0.WRITE_MODE1 = 2'b00;
defparam dpb_inst_0.BIT_WIDTH_0 = 2;
defparam dpb_inst_0.BIT_WIDTH_1 = 2;
defparam dpb_inst_0.BLK_SEL_0 = 3'b000;
defparam dpb_inst_0.BLK_SEL_1 = 3'b000;
defparam dpb_inst_0.RESET_MODE = "SYNC";
defparam dpb_inst_0.INIT_RAM_00 = 256'h134D0632252C771F0154561543363057C14BC14FC14382478A4B864F2D430C7F;
defparam dpb_inst_0.INIT_RAM_01 = 256'hD5D4246E5AD1E0BBBDEE94C2FEC4C18F4F4D540F61314FD9B3BFE64953B2CEA5;
defparam dpb_inst_0.INIT_RAM_02 = 256'h3724BB2B4FF343FFABDFB38EA8B136A2C4D649F6C9DD854134F4CD18671B567F;
defparam dpb_inst_0.INIT_RAM_03 = 256'h13C363210E50F36A0A053B7BEE494EE5910F09341B53C6319F155F94579BD7A0;
defparam dpb_inst_0.INIT_RAM_04 = 256'h07D243BBEECC0C855FFCE6DE27094DD015EA5539F02F418D3B9CD676524031C6;
defparam dpb_inst_0.INIT_RAM_05 = 256'h5DC795080A58703A54EA4696DCE7B8BDE68985944EC54F898BE2CBD2080DEFBD;
defparam dpb_inst_0.INIT_RAM_06 = 256'h538921548E5D286D4D517BBC088654AC5358897095D78A3CEDE5E582BA19737E;
defparam dpb_inst_0.INIT_RAM_07 = 256'hBAC766255C88080670E81C9E40A1A0955353BC391B6CA022D55C563382D0F173;
defparam dpb_inst_0.INIT_RAM_08 = 256'h4D9279D0A2E11055944116D488D7250D5D243924119CA0644D0464D81C640A60;
defparam dpb_inst_0.INIT_RAM_09 = 256'h4C2892D0A2D144E891E8814D768464B0247E5C977075CA0A965366CB86409627;
defparam dpb_inst_0.INIT_RAM_0A = 256'hD0A2F4E2289F59B96104A4251861C61451A3929E67AA0925E9D12897139D413E;
defparam dpb_inst_0.INIT_RAM_0B = 256'hC20251464EA990850DA522B963C8143F91508452734579D71E7D014107A25908;
defparam dpb_inst_0.INIT_RAM_0C = 256'hD85555571378DD9F054D7C8CC8FB13F90D2CEAC4710AEE14D557137B334A4686;
defparam dpb_inst_0.INIT_RAM_0D = 256'hA42930239CEA3B79500152ACAB1AC6B1B57A8F8CEABA39B7E3B555696683813E;
defparam dpb_inst_0.INIT_RAM_0E = 256'h954B02234837F3CDBEBFB38F5BA3EBDC953D7751951D1CC04B48C6598671CEB3;
defparam dpb_inst_0.INIT_RAM_0F = 256'h6B40CF3FFBD1F6426F089D79F73FE55DBEBF9BA020004F4AEC34433910D0DBDF;
defparam dpb_inst_0.INIT_RAM_10 = 256'h79D49C7C90F95515D4014B7944856117579041271C71245E54434591AB5624A4;
defparam dpb_inst_0.INIT_RAM_11 = 256'h45CE42C2F1F7EFFFB456D42CC81542FFD1AC6B1AC11E695555145DB541F3FFBD;
defparam dpb_inst_0.INIT_RAM_12 = 256'h8EC47BCB23441243F9E34BB0479FAA31DEF27755F742C9A0F245CC2EE57BBBC5;
defparam dpb_inst_0.INIT_RAM_13 = 256'h5D865D6FFDFFFFE7547FB3B4255EEEE55DE45B65DDE75BC04596ABAFFD1729DA;
defparam dpb_inst_0.INIT_RAM_14 = 256'hD6AD587EEA2F19D3B55656E65D754B529E0952F2B27235E919D155656C553557;
defparam dpb_inst_0.INIT_RAM_15 = 256'hFFDB23BC92796060A8D7224B56EE45D32D76A88C24841053A967B60927992A16;
defparam dpb_inst_0.INIT_RAM_16 = 256'h5D426A07C6E8AF0B8A4579D72B616291A520DFF59F95370ED7C2C33D0BCE75D4;
defparam dpb_inst_0.INIT_RAM_17 = 256'h51156A4FCDD15B76631F9FCC117F17076437D92840563D950C52D05509DC12E7;
defparam dpb_inst_0.INIT_RAM_18 = 256'hBCE672955CBB712055ABC77EACC1E1B6D6A70F5B516D57C48713B151290DF120;
defparam dpb_inst_0.INIT_RAM_19 = 256'hADD45CE08847B8918DEF71555B47A369D3B1269555CB7519B987E3A724E04B91;
defparam dpb_inst_0.INIT_RAM_1A = 256'hDA11DE05609547E7C91F907EAF957507EAF95752FA21C3957BCA550D232E4530;
defparam dpb_inst_0.INIT_RAM_1B = 256'h5D6555941D6B69D7510000445D0E161445CF4B1FBB65645547F8919D047F8917;
defparam dpb_inst_0.INIT_RAM_1C = 256'hEB96BA00DFA1C7B04D7EA8EF4507DAC51D67BC514C7595795D6D1E2B55D67367;
defparam dpb_inst_0.INIT_RAM_1D = 256'h1572DE37BBECC36D414D7150C3837FC32DCE1818A7E56DC0AA69BAA6068AB6F4;
defparam dpb_inst_0.INIT_RAM_1E = 256'h15196D4D5672841043856F556FB1D5544C55B6D29745154131D5564587455B19;
defparam dpb_inst_0.INIT_RAM_1F = 256'hB08A47D046228A3BC22C5755B6D1FA081CBD607A535167AB2BFD2BED51440DB5;
defparam dpb_inst_0.INIT_RAM_20 = 256'h6E7FADC54A82B8542956AB020EB194F25924424C2CBC2CBCA020202060D52930;
defparam dpb_inst_0.INIT_RAM_21 = 256'hDC7DF3F0908E1B4D5C280A24EDD2C875645CFF646996D7B5A2751CBF3ACA38D8;
defparam dpb_inst_0.INIT_RAM_22 = 256'h52564E78B4D4B05DAF8DCB64ECE1964E35E5915A7A1E695BD55A297106B56512;
defparam dpb_inst_0.INIT_RAM_23 = 256'hF7058F17164612E03DA554B05F7D8ACE1D564D5A492D854F2473B161F65EF859;
defparam dpb_inst_0.INIT_RAM_24 = 256'h2E1CA501324DB9971887106ADD6D7161F5BA5C621D5DCED86955D771A992AB74;
defparam dpb_inst_0.INIT_RAM_25 = 256'h97E7546D315055558571D9411539565AC57DCD771456AD7B214CEA05C20B60E3;
defparam dpb_inst_0.INIT_RAM_26 = 256'h00ADFEBD7D99005E5C57156738F4E5BF6ED595B160BF171D1FD0FE7EBECE5D55;
defparam dpb_inst_0.INIT_RAM_27 = 256'h0805565C57145D9120CC31800E000801500E808C032000404A02C83620ADC000;
defparam dpb_inst_0.INIT_RAM_28 = 256'hC080F9045159F5545F7156A2C56248DB5144D51558E165E71855C5467795DB6B;
defparam dpb_inst_0.INIT_RAM_29 = 256'h772EC141CFDC4D5B5F741426ACB51E56535545595E4535D52514040FFA8228AE;
defparam dpb_inst_0.INIT_RAM_2A = 256'hD75875717B57177D5C512551F7547D7772CC54B096B4A454A7F09742D296BFBF;
defparam dpb_inst_0.INIT_RAM_2B = 256'h8C9C646436CA3E574975C49544192638543551D15751DE94F0D8AE7017CB7587;
defparam dpb_inst_0.INIT_RAM_2C = 256'h416504944067261F31C76B89A99BB92BEB9B45674564625475111FDBC7F640E8;
defparam dpb_inst_0.INIT_RAM_2D = 256'h59E51C7CC41C1693B1D5DAE91164224EE42648E4AE2E1C4CD6A469FDB3699B3C;
defparam dpb_inst_0.INIT_RAM_2E = 256'h09C8E4E63A49B609B9DAC24D99F1CE53C5444340D0BC987C909814DD9C78701D;
defparam dpb_inst_0.INIT_RAM_2F = 256'h188FBC9C34F476CF2D2FB6F521927FC1F0A9FC25AE49BC6B27E7133A405E5515;
defparam dpb_inst_0.INIT_RAM_30 = 256'hA467567456745CBFC879AB847F5FA951BAD786DA77554163050360908FD188E4;
defparam dpb_inst_0.INIT_RAM_31 = 256'h8C8CB0B57AACF3D04C385EF8FAEA43BFA08FFA1540E62C2E305DD3A0EDE43173;
defparam dpb_inst_0.INIT_RAM_32 = 256'hA021703B69948643CADD451127E3E17B86E4135A1458242E937800004D36292C;
defparam dpb_inst_0.INIT_RAM_33 = 256'h5E7E679ED91457DBD4809D023B1B042B28A2BDEC244228A249268A2970ACA010;
defparam dpb_inst_0.INIT_RAM_34 = 256'hED79AFF8A07D504241B875E4A2B15F52B318AF6CA28D545451F5BC122F94DCA5;
defparam dpb_inst_0.INIT_RAM_35 = 256'hEEC2BD1D55854FFBF3BEFF5319555C6715C1C70B7C6D5A64A5C550AE0AE96E4E;
defparam dpb_inst_0.INIT_RAM_36 = 256'h286382F2BCC95A3B346FF19109520CFB93EEF3B902777ACE6F1B54410BF0EFF2;
defparam dpb_inst_0.INIT_RAM_37 = 256'hE456D4E2428EAE3AC21B3AB38AFCEF0BDF92E793942FD5F4E15F0BC25D18E195;
defparam dpb_inst_0.INIT_RAM_38 = 256'h1732C04EF260B2828EF40F3BA0EC8A6D5DD31C7A1AFE18C6EDF13A0ABEFB3B1A;
defparam dpb_inst_0.INIT_RAM_39 = 256'h18A94557658675D0A17B425F5AAADF29F55D2C25459F5089F4BEE7486EEFCE44;
defparam dpb_inst_0.INIT_RAM_3A = 256'h88ABDB9272FB8B62167DE6BDE49CDE2BBB6AEDED2A0D290F1D6CE5FD555D95C6;
defparam dpb_inst_0.INIT_RAM_3B = 256'h557B9CA1B6890E8EA4517D38A1901529E4E14A5C44C11B023C5CEC2D4C9264E4;
defparam dpb_inst_0.INIT_RAM_3C = 256'hA76074B25579ED153074B0BA9B239DF86A30A71F495C13D8974AFD85D949269E;
defparam dpb_inst_0.INIT_RAM_3D = 256'h62C6C4CA5A26096786E8D30F3729F6975B29577819D5DDB742DAD0466B8F464F;
defparam dpb_inst_0.INIT_RAM_3E = 256'h5394EA5F4A55DD53755931B1C28C2BB5606D17B7D773B795388ECAC0EC48A5B6;
defparam dpb_inst_0.INIT_RAM_3F = 256'hBDAB31DDA46D8EFFC38CA2B28E09B8A43A8A12E2702B521F7C6EC5FCA328C2E6;

DPB dpb_inst_1 (
    .DOA({dpb_inst_1_douta_w[13:0],dpb_inst_1_douta[3:2]}),
    .DOB({dpb_inst_1_doutb_w[13:0],dpb_inst_1_doutb[3:2]}),
    .CLKA(clka),
    .OCEA(ocea),
    .CEA(cea),
    .RESETA(reseta),
    .WREA(wrea),
    .CLKB(clkb),
    .OCEB(oceb),
    .CEB(ceb),
    .RESETB(resetb),
    .WREB(wreb),
    .BLKSELA({gw_gnd,gw_gnd,ada[13]}),
    .BLKSELB({gw_gnd,gw_gnd,adb[13]}),
    .ADA({ada[12:0],gw_gnd}),
    .DIA({gw_gnd,gw_gnd,gw_gnd,gw_gnd,gw_gnd,gw_gnd,gw_gnd,gw_gnd,gw_gnd,gw_gnd,gw_gnd,gw_gnd,gw_gnd,gw_gnd,dina[3:2]}),
    .ADB({adb[12:0],gw_gnd}),
    .DIB({gw_gnd,gw_gnd,gw_gnd,gw_gnd,gw_gnd,gw_gnd,gw_gnd,gw_gnd,gw_gnd,gw_gnd,gw_gnd,gw_gnd,gw_gnd,gw_gnd,dinb[3:2]})
);

defparam dpb_inst_1.READ_MODE0 = 1'b0;
defparam dpb_inst_1.READ_MODE1 = 1'b0;
defparam dpb_inst_1.WRITE_MODE0 = 2'b00;
defparam dpb_inst_1.WRITE_MODE1 = 2'b00;
defparam dpb_inst_1.BIT_WIDTH_0 = 2;
defparam dpb_inst_1.BIT_WIDTH_1 = 2;
defparam dpb_inst_1.BLK_SEL_0 = 3'b000;
defparam dpb_inst_1.BLK_SEL_1 = 3'b000;
defparam dpb_inst_1.RESET_MODE = "SYNC";
defparam dpb_inst_1.INIT_RAM_00 = 256'h312401C28C408A0838423384A12D4098A100230C210CE5486144E1400200004C;
defparam dpb_inst_1.INIT_RAM_01 = 256'h00BC080F2AD4B0D7EA47B22377A71C0568E7100BC808802550001034C10D0244;
defparam dpb_inst_1.INIT_RAM_02 = 256'h913399DBCDDFA3E7874C605DE0EFF783BED30CD83F200A8D7C820E406823DE86;
defparam dpb_inst_1.INIT_RAM_03 = 256'h0ACCB187CDE182FC8FC223C8F2FE0C302891189F23492D12978BDF4A2B0BE382;
defparam dpb_inst_1.INIT_RAM_04 = 256'h5627C3FFFFFEF61E20024220E6844F18060E56FA262093C38CECBFBFE710922A;
defparam dpb_inst_1.INIT_RAM_05 = 256'h7D1D1D3EAC73C30C7A75871C3EF997A32ECF2032CC1E660A0182A025888F040D;
defparam dpb_inst_1.INIT_RAM_06 = 256'h0186196C464F108E0B47B7720A4E8042D0D0189383DA8E58EA47C76F0EA1D304;
defparam dpb_inst_1.INIT_RAM_07 = 256'hFB097FB84C440D85D22D3573C3EBF0E802E22F29BFF0B2F3D583DF928CE84BBA;
defparam dpb_inst_1.INIT_RAM_08 = 256'h25F5CF2184E2320460C811C8C6A18F9BAC5D0F7D7170B6F5E24C5E3D387CB7D8;
defparam dpb_inst_1.INIT_RAM_09 = 256'hDD50A18942AB5E519390B0AE5F285CDE1C97EC7AB5C74C0DF4F97D7475F0D239;
defparam dpb_inst_1.INIT_RAM_0A = 256'h09421B00B0A5CC5F9B2D2D6FB6FBEFBAC95BDBDEF7ACAD72F71350AB0372802D;
defparam dpb_inst_1.INIT_RAM_0B = 256'hAB6B50E3AF4BD0CB83F631F22304058F7538F5D4DA0C235538DAC050C1465F0F;
defparam dpb_inst_1.INIT_RAM_0C = 256'hD5135D8120FC37D7AD0344E6E7D4B01E43BA2FAA82AB3934102D90CF990BAB2B;
defparam dpb_inst_1.INIT_RAM_0D = 256'hD7BE9653ACC13A8C195402E83A1E8FA1716FCFECE41B336CD3380C873CC021BA;
defparam dpb_inst_1.INIT_RAM_0E = 256'hA613039B5A19C93EC6CED326CD24517500571BD2C27A7BF0991A68E368C0837C;
defparam dpb_inst_1.INIT_RAM_0F = 256'h9800E7BE7BEBF96321A46EDBED3DF12EC6CCE0B13313938716D128144A5E73E5;
defparam dpb_inst_1.INIT_RAM_10 = 256'h38A0989ED64C05A1520002329CE9C803B170006DC4D88D05D44404C4E99CA440;
defparam dpb_inst_1.INIT_RAM_11 = 256'h11808C4E5AD96D95BF8040C4CC3D4CDF80384E23967FAA708F89EC880F7BE7BE;
defparam dpb_inst_1.INIT_RAM_12 = 256'hBA49D044131009B37C2919011175219AF418139E9BE2464AD313E637333FD001;
defparam dpb_inst_1.INIT_RAM_13 = 256'h046804BFD643DD70284193A6502131302808028E90240AAE70A499A1DE793C09;
defparam dpb_inst_1.INIT_RAM_14 = 256'h6B2F846A0690AC0BA9DB2663231280E0AEFA01A3A3A38AE7AC0A9DB2668C9018;
defparam dpb_inst_1.INIT_RAM_15 = 256'h7760B9B1CB30C02F9868137BC25102F9AFBE6B86A0BC00230C02AF0C650A6682;
defparam dpb_inst_1.INIT_RAM_16 = 256'hEF4BAA018594FB4B8F1213669AF02BC4BEB2689E39279A32A1316DD72EF7BEF6;
defparam dpb_inst_1.INIT_RAM_17 = 256'h35DD6A7F3BA70BE68FAD9772ACDDE20DE92A7A32201A85CCE00CF33B2C08D9BB;
defparam dpb_inst_1.INIT_RAM_18 = 256'hE67313CCA27BE13F30A87B7E87BF6E02F6A1A40BE72F0224FC8F9C03DA4ABA30;
defparam dpb_inst_1.INIT_RAM_19 = 256'h47731610E68C96CCC427DC4DFCCD26F33F18C1BB3044BD2CE44E8964B7D09984;
defparam dpb_inst_1.INIT_RAM_1A = 256'h67A1A3813A52847BE4C7E8C0EDCC128C0EDCC1219261054C9E871334E985129B;
defparam dpb_inst_1.INIT_RAM_1B = 256'hC42000ED67A93A313440002CC0E11032CF376D94943BAE9E8C5EF84028E7ED93;
defparam dpb_inst_1.INIT_RAM_1C = 256'hBC9FEAE0CB6F6D013754867ABE86834008C9004486DC8EDCC72FC24BEC422BAE;
defparam dpb_inst_1.INIT_RAM_1D = 256'hD55BB4891C3BCDA36064AD08EF92730764ABBDBEF53C7B51F63D8FE767DBFA62;
defparam dpb_inst_1.INIT_RAM_1E = 256'h72FFE3EECBF4BD0521BDB0000D9ECAAD8FC0BC51D5A6C0FC9555B3F2D5680A48;
defparam dpb_inst_1.INIT_RAM_1F = 256'h728D00F00C708A394A110AD778A7A4A47E4ED1FAC9E47C3B15162E50279EB78E;
defparam dpb_inst_1.INIT_RAM_20 = 256'h490735E29FA3E1EB10D04DD246000D535E10088859621860FEF23E7276402E98;
defparam dpb_inst_1.INIT_RAM_21 = 256'h0A18A130C9EBBD4C58AD8F8420C1023749EF63C9582D00B227480844098977F4;
defparam dpb_inst_1.INIT_RAM_22 = 256'hC8F4903A3081BB5C2356C40105073C90B460067522FA1C96FC021AC462B65383;
defparam dpb_inst_1.INIT_RAM_23 = 256'hC21D008BC010734CFCE500BB531CD6CD564016770C2CBD4C09C08007D4B0F1E2;
defparam dpb_inst_1.INIT_RAM_24 = 256'hC9B0439281E600AC46BC850E640F7B09EC22B31AFE0084F664CE310400C60174;
defparam dpb_inst_1.INIT_RAM_25 = 256'h0F0309EBDB5E8CC50C00B723B475543B302BF79CCBD4858CD3A00D86C12B5C1D;
defparam dpb_inst_1.INIT_RAM_26 = 256'h007ACF0E3F12008434C000091BCDD0A053950DC859C0800A7170AF878D9D2F55;
defparam dpb_inst_1.INIT_RAM_27 = 256'h53A9C2328C09E200212410400C002401400A801901980940AC02080F507AD000;
defparam dpb_inst_1.INIT_RAM_28 = 256'hC5CA4801B6234D0236D862118E0B1A7A089E70AD630C0003CBD08D50BF6569A9;
defparam dpb_inst_1.INIT_RAM_29 = 256'hAAB1804081B6270BD2BD3527A7BE85D8C9D56C06339C9EF5C270000FFE8E1A37;
defparam dpb_inst_1.INIT_RAM_2A = 256'hB72159DB519D371308E78C27E089DB6141C8106327BC88418407338EA29505CD;
defparam dpb_inst_1.INIT_RAM_2B = 256'hF9CEEDE1F39CA6A61B414238038C68C39E04E7A705E72E5C466576700B984211;
defparam dpb_inst_1.INIT_RAM_2C = 256'h744E54E1167F7070C514435DA88BB9989A8B032110320E76546A615B599A00EB;
defparam dpb_inst_1.INIT_RAM_2D = 256'hCD474F4F1455D9D3F5DD10C1657BC557157951155C7C534D34C541353446D375;
defparam dpb_inst_1.INIT_RAM_2E = 256'h5EC13978407104405E1DD815D404F01CD45754BD2DF1E06C55E0F52141414FE9;
defparam dpb_inst_1.INIT_RAM_2F = 256'hA711C1E16D2DADF3DD50492534C783097DC00C39101ED3F372EE147F659BB75E;
defparam dpb_inst_1.INIT_RAM_30 = 256'h0021032210332FAFDC0EDCCEDDEDFCC2CCC362D100212CF15B59855D200C5137;
defparam dpb_inst_1.INIT_RAM_31 = 256'hE4FC4D7D50F10CF58D437DC5D31E92262E2516B733626C293FAA9FE29ABD3C21;
defparam dpb_inst_1.INIT_RAM_32 = 256'h26F896FF5DE84E6AA3C1BDA8338A2244C33842103910380C10BDC000822D3A34;
defparam dpb_inst_1.INIT_RAM_33 = 256'hC2D2F8BF47A0B9F4946809C21211B72A306228A0A90C20270C70C02B04342ADC;
defparam dpb_inst_1.INIT_RAM_34 = 256'h20CBFE340C3E1686A034032CCAEF4FD099080F3312A7A0B2CF2CF5DD6FC270A6;
defparam dpb_inst_1.INIT_RAM_35 = 256'h388680BBC7BC841AA1A00046209D80A1909DBE3254CD780C408DACF28FBB62F6;
defparam dpb_inst_1.INIT_RAM_36 = 256'h10210070381409326C81103B18B18EF4E3D30A4F464293DE3E9FCA40E02C3C09;
defparam dpb_inst_1.INIT_RAM_37 = 256'hD7C5C7AF63FA3FE342F9D8DE8FA86B0300B32FE394CDCB2C012022820B3082B3;
defparam dpb_inst_1.INIT_RAM_38 = 256'h108C1AA76C9003DA702EF8049CB309782A8886B48F243EFA6182B77C4B742D8F;
defparam dpb_inst_1.INIT_RAM_39 = 256'h0FF8014BE32BE58FF00BFC41D9267C093763B88A4273331E4E8338C3800A86D9;
defparam dpb_inst_1.INIT_RAM_3A = 256'h8CBC94E821D93F219F182FFF2FDE4A024CB93246AF231314B110E55D49EF8D2F;
defparam dpb_inst_1.INIT_RAM_3B = 256'h8223E801A88DC6A24802CB10612B7508D001040B4D33207392E8C86AFCF8B4BE;
defparam dpb_inst_1.INIT_RAM_3C = 256'hDE2628712AA26E85102EA3AFE0B236EE3F93F23084038946FD8F5C664FEC70C3;
defparam dpb_inst_1.INIT_RAM_3D = 256'h284E47002073229F483EA2DBC309DFB44C0948CCBC8C7BA000A8E20AA9BCC246;
defparam dpb_inst_1.INIT_RAM_3E = 256'h22BA2EFD4F823278E9CE32B0C2CC64C42863AC407563277F9A0D232A7684E0CF;
defparam dpb_inst_1.INIT_RAM_3F = 256'hF7E92FD3ECED320011C802A384BD08EF9F08E26008FEF2BAF237BE8CA90A80B8;

DPB dpb_inst_2 (
    .DOA({dpb_inst_2_douta_w[13:0],dpb_inst_2_douta[5:4]}),
    .DOB({dpb_inst_2_doutb_w[13:0],dpb_inst_2_doutb[5:4]}),
    .CLKA(clka),
    .OCEA(ocea),
    .CEA(cea),
    .RESETA(reseta),
    .WREA(wrea),
    .CLKB(clkb),
    .OCEB(oceb),
    .CEB(ceb),
    .RESETB(resetb),
    .WREB(wreb),
    .BLKSELA({gw_gnd,gw_gnd,ada[13]}),
    .BLKSELB({gw_gnd,gw_gnd,adb[13]}),
    .ADA({ada[12:0],gw_gnd}),
    .DIA({gw_gnd,gw_gnd,gw_gnd,gw_gnd,gw_gnd,gw_gnd,gw_gnd,gw_gnd,gw_gnd,gw_gnd,gw_gnd,gw_gnd,gw_gnd,gw_gnd,dina[5:4]}),
    .ADB({adb[12:0],gw_gnd}),
    .DIB({gw_gnd,gw_gnd,gw_gnd,gw_gnd,gw_gnd,gw_gnd,gw_gnd,gw_gnd,gw_gnd,gw_gnd,gw_gnd,gw_gnd,gw_gnd,gw_gnd,dinb[5:4]})
);

defparam dpb_inst_2.READ_MODE0 = 1'b0;
defparam dpb_inst_2.READ_MODE1 = 1'b0;
defparam dpb_inst_2.WRITE_MODE0 = 2'b00;
defparam dpb_inst_2.WRITE_MODE1 = 2'b00;
defparam dpb_inst_2.BIT_WIDTH_0 = 2;
defparam dpb_inst_2.BIT_WIDTH_1 = 2;
defparam dpb_inst_2.BLK_SEL_0 = 3'b000;
defparam dpb_inst_2.BLK_SEL_1 = 3'b000;
defparam dpb_inst_2.RESET_MODE = "SYNC";
defparam dpb_inst_2.INIT_RAM_00 = 256'hE21E04024513C38C34D12749D320C004524491409140500090009000D280034B;
defparam dpb_inst_2.INIT_RAM_01 = 256'h0640A4EC5D458BF0E94D45EFE36F826DF72808040FCADA8D36EE319092ABBBCA;
defparam dpb_inst_2.INIT_RAM_02 = 256'hFC33F5FCD38CF575C1303C5D47E48D1392330C9624AE202AA2AA6AA4B9BEA14E;
defparam dpb_inst_2.INIT_RAM_03 = 256'hBCF03644AEEB232CCFC82D8C731C8B329A831B931EDB10B1E660272DC864B0D6;
defparam dpb_inst_2.INIT_RAM_04 = 256'hFAE141555555F9200AA2C7882972B0E7288284F539E238CC0EC8C32D3A9BEAA3;
defparam dpb_inst_2.INIT_RAM_05 = 256'hC01033BFBCC236ACC2F0E73042B5105C22EC0C830610D01C1C079002CF70C0CE;
defparam dpb_inst_2.INIT_RAM_06 = 256'h328C03130A082C78484039822C8F1CB0331A2CF1C00A2518688C8C5FCDB3342C;
defparam dpb_inst_2.INIT_RAM_07 = 256'hC32F34432243CD43774C005378E8DEF34331F71C8C32363107111331C7B4C426;
defparam dpb_inst_2.INIT_RAM_08 = 256'h2CD249C28798E109FB8417E3FB4F800038348D34D0D632337700374C0335B35E;
defparam dpb_inst_2.INIT_RAM_09 = 256'hCC21CB8887B70021CCE1F2D8371D32C212F348B3E34DFCECD34B35BCB32CC9BF;
defparam dpb_inst_2.INIT_RAM_0A = 256'h8887B24721C3488D2BACCC4FBEFBACBAE958D8C8320C8D04BB8C31C713B8412E;
defparam dpb_inst_2.INIT_RAM_0B = 256'hA7E349A3A720EEC00C38FE04B9AC1857F648F0231638A2E7B8B8C001C887800F;
defparam dpb_inst_2.INIT_RAM_0C = 256'h2199662C730CCCFE444C6ECF4388031C0C388F8F3BC3B8C22800432CBF43E723;
defparam dpb_inst_2.INIT_RAM_0D = 256'hC83EDD31C8731E0E2556F3C0700C030218BFF5B472FF1FA0D1E0A58924E338B1;
defparam dpb_inst_2.INIT_RAM_0E = 256'hE02EEB1E91BCA811E5E5C61208CE14C1CAC4E135D0C88B8D332CF0001012A321;
defparam dpb_inst_2.INIT_RAM_0F = 256'h580091D75C72A0D050C401D75C6BB280E4E4D8130011308B82F2B2F0A2C73C35;
defparam dpb_inst_2.INIT_RAM_10 = 256'h0E91A3E4AAECAA2A29401A0F108135300C404050E10E204107D34CCA4B10E0EC;
defparam dpb_inst_2.INIT_RAM_11 = 256'h2A2FC3431E1D75D1DFE1FC33C40C835280F83E0FBC4E504430620142AE1D75C4;
defparam dpb_inst_2.INIT_RAM_12 = 256'h07B1084E0C2810316CB32CC32840D03CC30FBA10B104C0FE422B6F2282ABCC2B;
defparam dpb_inst_2.INIT_RAM_13 = 256'h4A114A2473E9F7328E2742E10248899288AA2A00A8AA2ADCF287321258432CA3;
defparam dpb_inst_2.INIT_RAM_14 = 256'h81000E248509F8A0512184D2442821C8C7ECA1E3E3E3E248F8A312184F056251;
defparam dpb_inst_2.INIT_RAM_15 = 256'hD4185210C3186083318841720A102843C830C0EA68001402CCA630DCB8E34CCA;
defparam dpb_inst_2.INIT_RAM_16 = 256'h0CDFC40BE380B8635F28C87F7334B7CA039F8C3003C4E03B481025C45C7A10C8;
defparam dpb_inst_2.INIT_RAM_17 = 256'h800184F00888B0207815E1717105CAEED0EAB676F0A3AFC611C78BC87CA2FFA1;
defparam dpb_inst_2.INIT_RAM_18 = 256'h20F2B2CA2122232C42849E487F802C040473C0400880826C80D1FD3B243A9E70;
defparam dpb_inst_2.INIT_RAM_19 = 256'hFC418328C7E2F4066CB214A00010CE04C0FC72C82B0E137F22E25F1A0F9D3349;
defparam dpb_inst_2.INIT_RAM_1A = 256'h42799C068C6CE2DC806ECE25580528E2518052838CF88C063A8B28BC70DC28BC;
defparam dpb_inst_2.INIT_RAM_1B = 256'h0A04C633C0532C42852000D30A12878310D1019D41CC0010E2DC244ADE6DC61A;
defparam dpb_inst_2.INIT_RAM_1C = 256'hB03BE128CAC830C38CB340FA30E2770058BCC2CA2F1021006477CB1630A04F50;
defparam dpb_inst_2.INIT_RAM_1D = 256'h31B4CD65E00D620886AA32EE1C379624578B0D2C358E8CE8CCB32C8B6322C962;
defparam dpb_inst_2.INIT_RAM_1E = 256'h8CC00850330F02171F03C048A1FC39A5741287BDE034DB1B1BB93C2CEEC24133;
defparam dpb_inst_2.INIT_RAM_1F = 256'h91E039801D35152D47FB2322C784AC89CA8137212A1A8CDDD000CF1108204C20;
defparam dpb_inst_2.INIT_RAM_20 = 256'h3BECBB6C0BEFE600F5384CCF570041518CB387382EE26FE2BABEF2363670A3CA;
defparam dpb_inst_2.INIT_RAM_21 = 256'h0EF88D8BC2CB2D14EBAFAF14F8A3B28C9BC8F61B1D4006547320E8EEECF123AD;
defparam dpb_inst_2.INIT_RAM_22 = 256'h15C1B57F11C6C7C9B04F5C54DCD871B5D17240415C04702E309F50116658BBB4;
defparam dpb_inst_2.INIT_RAM_23 = 256'hC67050F231FD800CE97CC5C73414CB013FC90C4115C9019C5BC38B1801858536;
defparam dpb_inst_2.INIT_RAM_24 = 256'hCF7BD40B6FCE4E01D102D7168DD0C4E7034C064403503909C720429965CB6AE5;
defparam dpb_inst_2.INIT_RAM_25 = 256'h5356230CC0813068ACEE8CBC0A21B143448C8C31E321A902B008EB20021C0F1C;
defparam dpb_inst_2.INIT_RAM_26 = 256'h00C4CFE6DF93001D46CEE4A7E79C82AA08AC50D544D5CEE8C8CFA1E5E5C88C6C;
defparam dpb_inst_2.INIT_RAM_27 = 256'h4FB110C1312228200229242000001400E00D0012013809901381DC0380C4C000;
defparam dpb_inst_2.INIT_RAM_28 = 256'h3D8000058780134C000ECD0000D32C0B4C2004004064A8A9E034005B33F13353;
defparam dpb_inst_2.INIT_RAM_29 = 256'hEA220186000380400A31C9CD3F326120202C4D30CB2200C93480000FFE9EAC2E;
defparam dpb_inst_2.INIT_RAM_2A = 256'h0483F1007F1044844008210C14020048803B2822C320A7A9CAA7280B92A56CE1;
defparam dpb_inst_2.INIT_RAM_2B = 256'hCEDCDCDFE3C8F404946A188500CCB0DB10840C88840801262D1A17300054581C;
defparam dpb_inst_2.INIT_RAM_2C = 256'h00101501050001010451140099A988B82133322222111A76447046BA933000EA;
defparam dpb_inst_2.INIT_RAM_2D = 256'h0010001015400004050145144000000040400540014144114115114045101441;
defparam dpb_inst_2.INIT_RAM_2E = 256'h5015420155045554405018140440010014100501410105010105015445151000;
defparam dpb_inst_2.INIT_RAM_2F = 256'h4000110202420000001141004404141400155140441007F401AA454006400080;
defparam dpb_inst_2.INIT_RAM_30 = 256'h32111000003336B67A2444477464575B646A894B130336628090190240406540;
defparam dpb_inst_2.INIT_RAM_31 = 256'h7878700055015104381041000440E4C0408044C88CCCCC047FF4B9788AA6AB1A;
defparam dpb_inst_2.INIT_RAM_32 = 256'hA916E37E4EC00EB603486242018AFAA203BC22AC0404AA3BC8BC0C0004121030;
defparam dpb_inst_2.INIT_RAM_33 = 256'h6212348F484AC79CB288EBCE3A38BB2A28A1CC50A70A28A904504A19069CF2EC;
defparam dpb_inst_2.INIT_RAM_34 = 256'hD208FA3CAB5F5F4AD2E34822CED85222BB2CAFA411E86AC30800C8ECC7DA88A9;
defparam dpb_inst_2.INIT_RAM_35 = 256'hBA8A70C50C71EDB562ABBA9E3A5208E69DA4622AF4785530AD4102FBAF94DCF5;
defparam dpb_inst_2.INIT_RAM_36 = 256'h18E38EA3ED8C241A20EBB2DC28025CEAE9ABA2EC0AA6510F409412419EEEBAA3;
defparam dpb_inst_2.INIT_RAM_37 = 256'hC1C1155F3FD4FF53CF7372C52FA8A83E208B23C1887AA800E3BA2A8A0C38E394;
defparam dpb_inst_2.INIT_RAM_38 = 256'h0B51AB2F1053C8CB45A50AD2F2F82F7938B16AD8EFA48F1FD6BB3B13E8D8FCEF;
defparam dpb_inst_2.INIT_RAM_39 = 256'h8CF501230C912980F0631BBB334CB22A909808AC25C981ED472BB1C7155A8A00;
defparam dpb_inst_2.INIT_RAM_3A = 256'h2DFE8206A00A7D91155923C823D2C72A6673B94EBF2E298C4C086821210C32B0;
defparam dpb_inst_2.INIT_RAM_3B = 256'h2C1EC8A3A627CE5107BB0038A38BBE28F8E38ACCC7331C0B3108E8A8FFDD3337;
defparam dpb_inst_2.INIT_RAM_3C = 256'h4189A45DE669556E506722ABD81E04DD3C52FBBB002B5D057123405147041041;
defparam dpb_inst_2.INIT_RAM_3D = 256'h94C72F8A98172B734605A996692A4143DE2A8601546005188A9D420E7575CE86;
defparam dpb_inst_2.INIT_RAM_3E = 256'h9582F501A7244AC82B1CD38D4A34A668AA80902ECE61A48253E1EB8CF0C032E5;
defparam dpb_inst_2.INIT_RAM_3F = 256'hD3432441CC743BAA8BC8A2A284743C508F47D8D374B518C202739184733D8E95;

DPB dpb_inst_3 (
    .DOA({dpb_inst_3_douta_w[13:0],dpb_inst_3_douta[7:6]}),
    .DOB({dpb_inst_3_doutb_w[13:0],dpb_inst_3_doutb[7:6]}),
    .CLKA(clka),
    .OCEA(ocea),
    .CEA(cea),
    .RESETA(reseta),
    .WREA(wrea),
    .CLKB(clkb),
    .OCEB(oceb),
    .CEB(ceb),
    .RESETB(resetb),
    .WREB(wreb),
    .BLKSELA({gw_gnd,gw_gnd,ada[13]}),
    .BLKSELB({gw_gnd,gw_gnd,adb[13]}),
    .ADA({ada[12:0],gw_gnd}),
    .DIA({gw_gnd,gw_gnd,gw_gnd,gw_gnd,gw_gnd,gw_gnd,gw_gnd,gw_gnd,gw_gnd,gw_gnd,gw_gnd,gw_gnd,gw_gnd,gw_gnd,dina[7:6]}),
    .ADB({adb[12:0],gw_gnd}),
    .DIB({gw_gnd,gw_gnd,gw_gnd,gw_gnd,gw_gnd,gw_gnd,gw_gnd,gw_gnd,gw_gnd,gw_gnd,gw_gnd,gw_gnd,gw_gnd,gw_gnd,dinb[7:6]})
);
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
