apuder/MiniPC/src/fpga/mini-pc/v0.1/src/gowin_dpb/blk_mem_gen_1.v

//Copyright (C)2014-2022 Gowin Semiconductor Corporation.
//All rights reserved.
//File Title: IP file
//GOWIN Version: V1.9.8.09 Education
//Part Number: GW2A-LV18PG256C8/I7
//Device: GW2A-18C
//Created Time: Sat Jun 17 07:18:41 2023

module blk_mem_gen_1 (douta, doutb, clka, ocea, cea, reseta, wrea, clkb, oceb, ceb, resetb, wreb, ada, dina, adb, dinb);

output [7:0] douta;
output [7:0] doutb;
input clka;
input ocea;
input cea;
input reseta;
input wrea;
input clkb;
input oceb;
input ceb;
input resetb;
input wreb;
input [15:0] ada;
input [7:0] dina;
input [15:0] adb;
input [7:0] dinb;

wire [14:0] dpb_inst_0_douta_w;
wire [0:0] dpb_inst_0_douta;
wire [14:0] dpb_inst_0_doutb_w;
wire [0:0] dpb_inst_0_doutb;
wire [14:0] dpb_inst_1_douta_w;
wire [0:0] dpb_inst_1_douta;
wire [14:0] dpb_inst_1_doutb_w;
wire [0:0] dpb_inst_1_doutb;
wire [14:0] dpb_inst_2_douta_w;
wire [0:0] dpb_inst_2_douta;
wire [14:0] dpb_inst_2_doutb_w;
wire [0:0] dpb_inst_2_doutb;
wire [14:0] dpb_inst_3_douta_w;
wire [0:0] dpb_inst_3_douta;
wire [14:0] dpb_inst_3_doutb_w;
wire [0:0] dpb_inst_3_doutb;
wire [14:0] dpb_inst_4_douta_w;
wire [1:1] dpb_inst_4_douta;
wire [14:0] dpb_inst_4_doutb_w;
wire [1:1] dpb_inst_4_doutb;
wire [14:0] dpb_inst_5_douta_w;
wire [1:1] dpb_inst_5_douta;
wire [14:0] dpb_inst_5_doutb_w;
wire [1:1] dpb_inst_5_doutb;
wire [14:0] dpb_inst_6_douta_w;
wire [1:1] dpb_inst_6_douta;
wire [14:0] dpb_inst_6_doutb_w;
wire [1:1] dpb_inst_6_doutb;
wire [14:0] dpb_inst_7_douta_w;
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
    .ADA(ada[13:0]),
    .DIA({gw_gnd,gw_gnd,gw_gnd,gw_gnd,gw_gnd,gw_gnd,gw_gnd,gw_gnd,gw_gnd,gw_gnd,gw_gnd,gw_gnd,gw_gnd,gw_gnd,gw_gnd,dina[0]}),
    .ADB(adb[13:0]),
    .DIB({gw_gnd,gw_gnd,gw_gnd,gw_gnd,gw_gnd,gw_gnd,gw_gnd,gw_gnd,gw_gnd,gw_gnd,gw_gnd,gw_gnd,gw_gnd,gw_gnd,gw_gnd,dinb[0]})
);
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
