apuder/MiniPC/(commit log)

2026-02-27 v0.1 of KiCad schematics and PCB
    [MiniPC.kicad_pcb, MiniPC.kicad_sch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]
2026-03-05 Move MiniPC KiCad files to sub-directory
    [MiniPC.kicad_pcb, MiniPC.kicad_sch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]
2026-03-08 Version 0.2 of MiniPC PCB
    [MiniPC.kicad_pcb, MiniPC.kicad_sch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]
2026-03-08 RS 232 PMOD PCB
    [rs232.kicad_pcb, rs232.kicad_sch]
2026-03-12 Add SPI client implementation
2026-03-18 SPI - FPGA
2026-03-22 First version of loading kernel.bin (not working)
    [partitions.csv]
2026-03-23 Almost working SPI (except first byte of MISO)
2026-03-23 Working SPI implementation
2026-03-26 TOS Hello World (via UART)
2026-03-28 Drop SPI SCK to 5 MHz. Various timing fixes
    [gowin_rpll1.v, gowin_rpll1_tmp.v, spi.cpp, spi.v]
2026-03-31 Fix for 16-bit sized PSRAM access
    [psram.v]
2026-04-09 Version 0.2 (April) of MiniPC PCB
    [MiniPC.kicad_pcb, MiniPC.kicad_sch]
2026-04-10 Fix corrupted t0 in context switch. Added shell and pong
    [dispatch.c, intr.c, kernel.h, keyb.c, main.c, pong.c, shell.c, top.v]
2026-04-14 Fix for context corruption. Added UART IRQ
    [debug.v, dispatch.c, intr.c, kernel.h, keyb.c, pong.c, process.c, simpleuart.v]
2026-04-17 Added UART2
2026-04-18 Fix for PSRAM soft reset
    [psram.v]
2026-04-24 Fix CDC issue in UART RX path
    [simpleuart.v]
